TobiasRohner/STM/Hardware/ControlBoard/Control_Board_Voegel.png

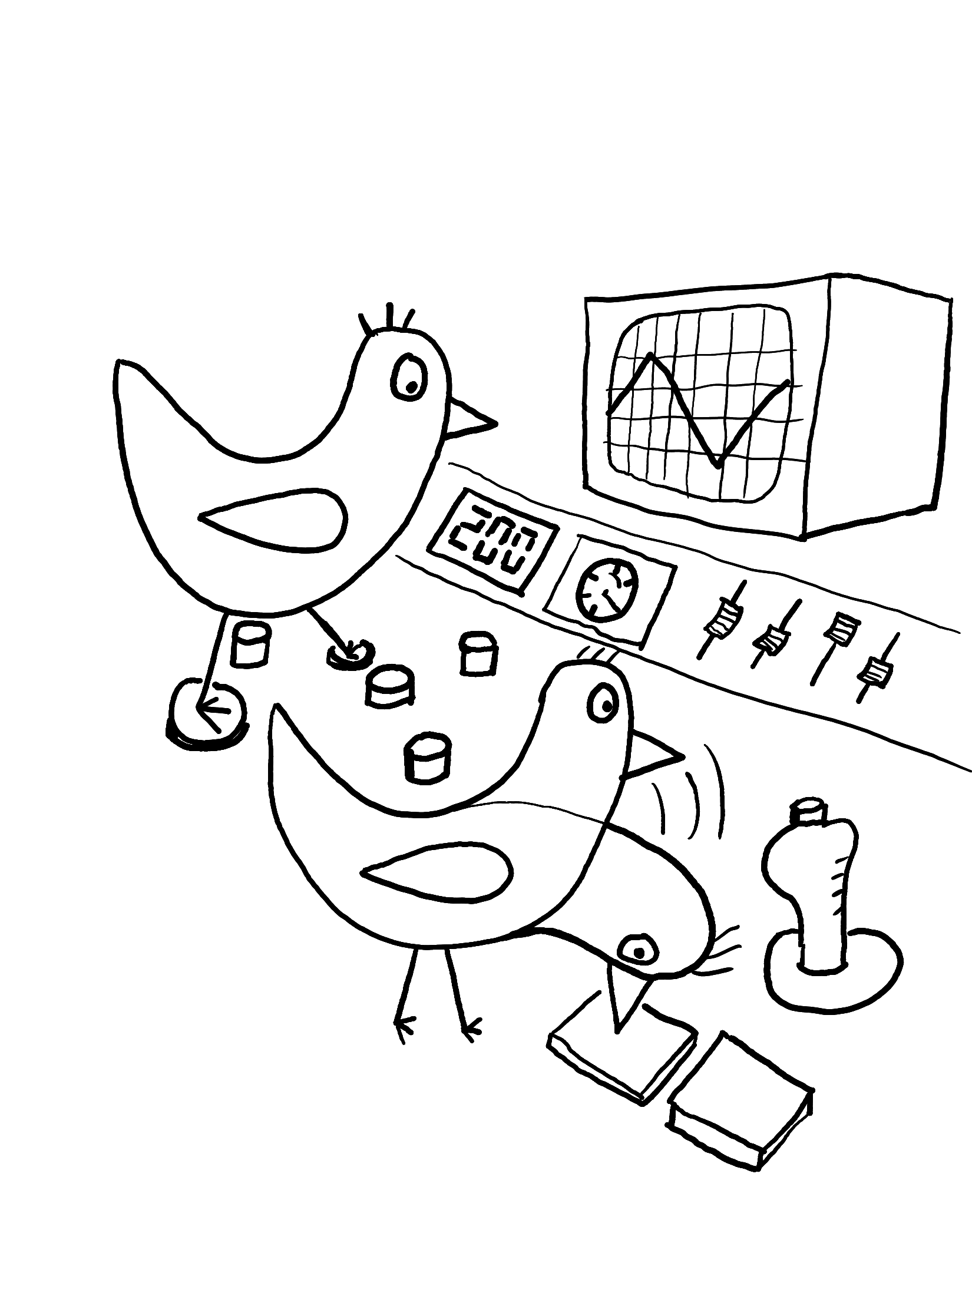
Hardware/ControlBoard/Control_Board_Voegel.png
