TobiasRohner/STM/Hardware/PSU/Artwork PSU.png

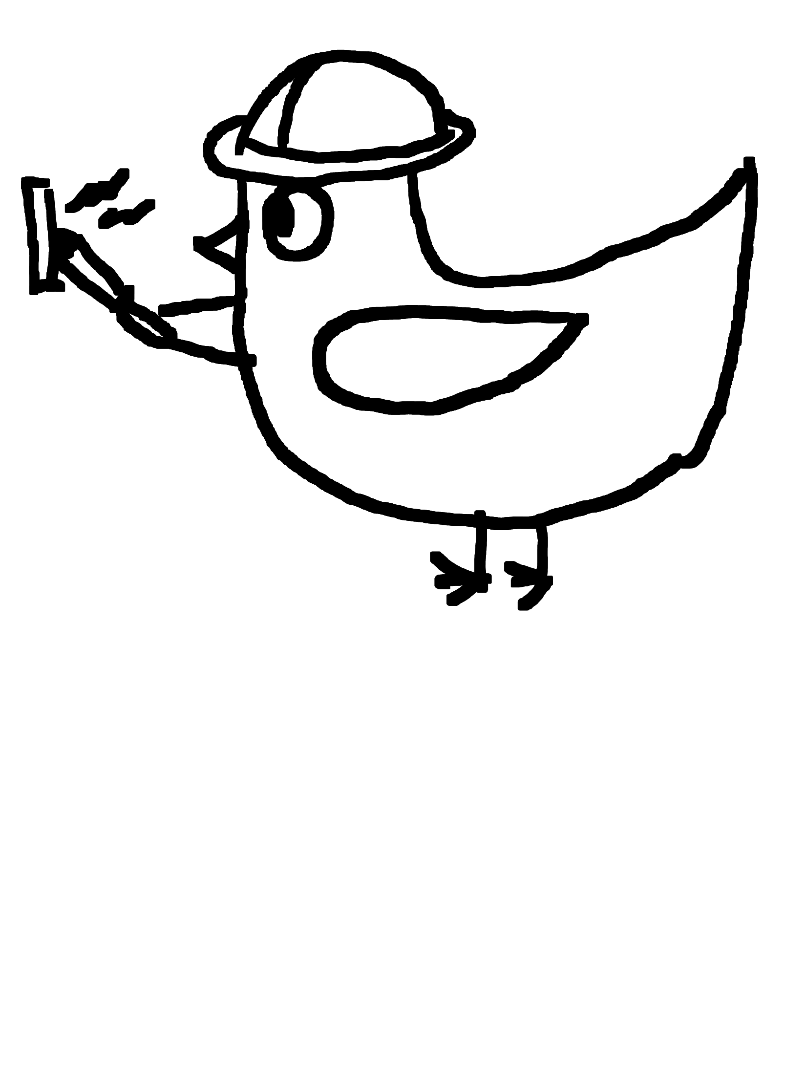
Hardware/PSU/Artwork PSU.png
