TobiasRohner/STM/Hardware/TIA/Artwork TIA.png

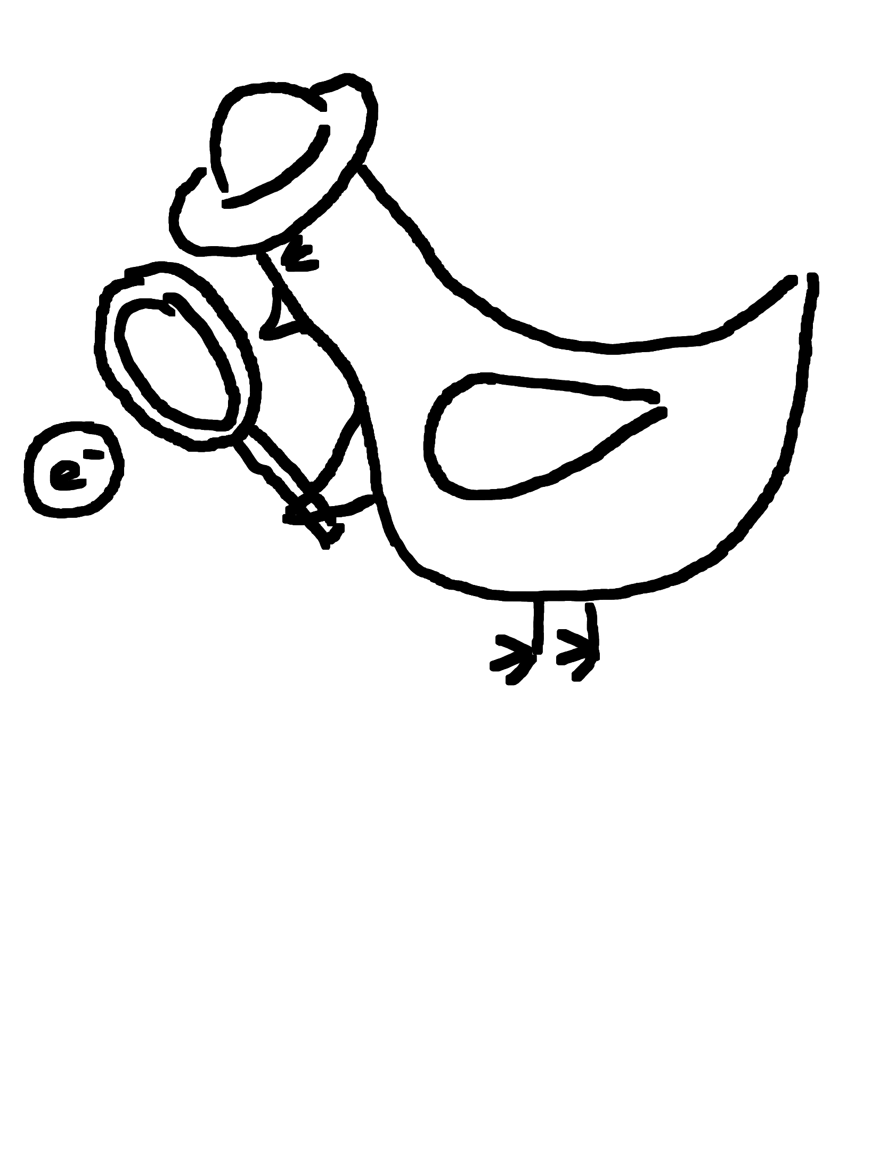
Hardware/TIA/Artwork TIA.png
