TobiasRohner/STM/Hardware/ControlBoard/OPA2227UA_2K5/THVD1429DT--3DModel-STEP-56544.STEP

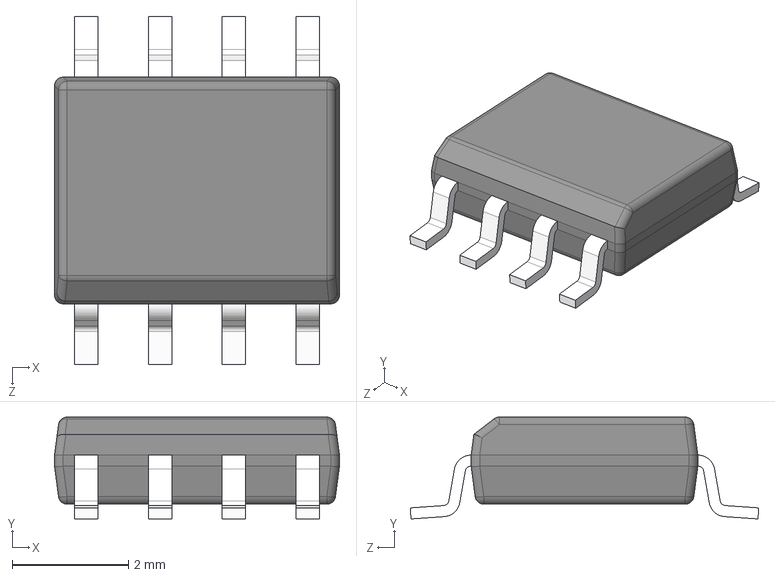
[picture p4: CAD file, 2022-01-10]
Hardware/ControlBoard/OPA2227UA_2K5/THVD1429DT--3DModel-STEP-56544.STEP
4.90 x 1.75 x 5.99 mm
