TobiasRohner/STM/Hardware/PSU/SS2PH10-M3/84A.STEP

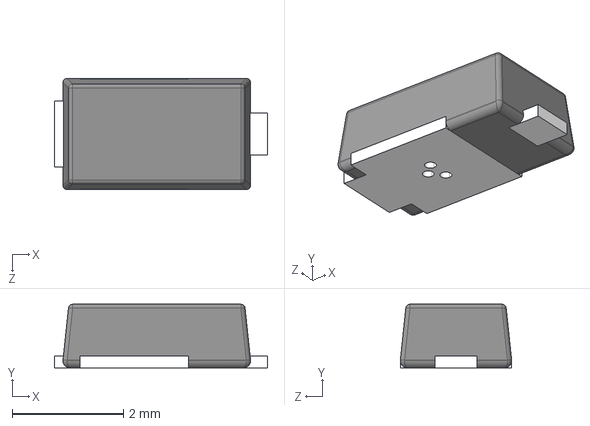
[picture p5: CAD file, 2022-01-10]
Hardware/PSU/SS2PH10-M3/84A.STEP
3.83 x 1.14 x 2.00 mm
