TobiasRohner/STM/Hardware/ControlBoard/10118194-0001LF/10118194-0001LF--3DModel-STEP-56544.STEP

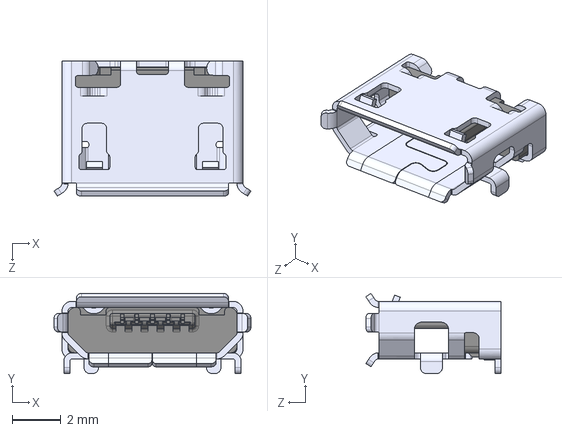
[picture p6: CAD file, 2022-01-10]
Hardware/ControlBoard/10118194-0001LF/10118194-0001LF--3DModel-STEP-56544.STEP
8.05 x 3.27 x 5.53 mm
