TobiasRohner/STM/Hardware/TIA/TIA.pdf

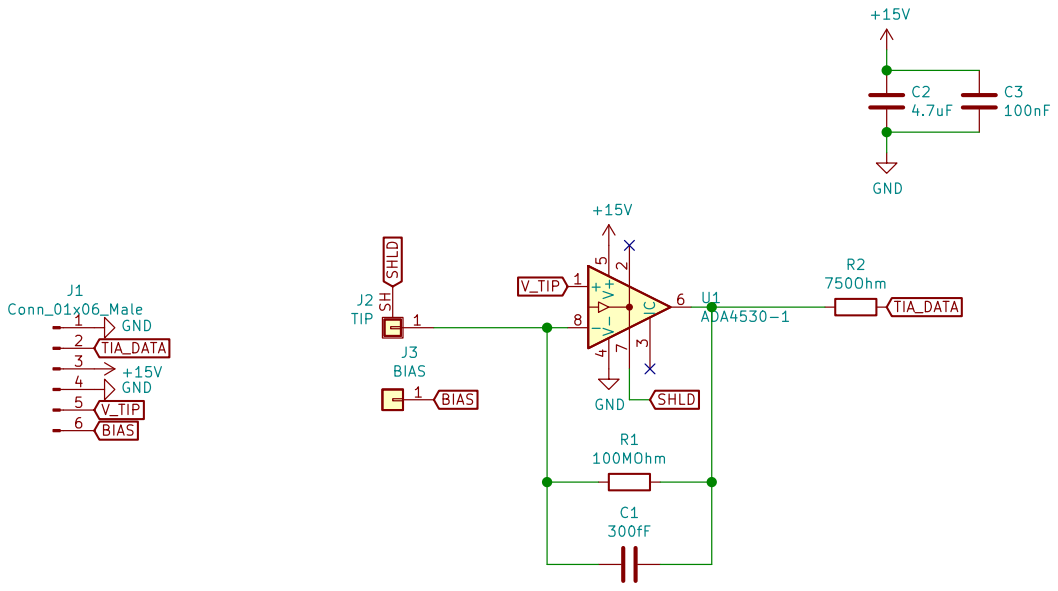
[picture p7: page 1]

Id: 1/1 Title: File: TIA.sch Sheet: /
