TobiasRohner/STM/Hardware/PSU/PSU.kicad_pcb

## KiCad design Hardware/PSU/PSU.kicad_pcb (2022-01-10)

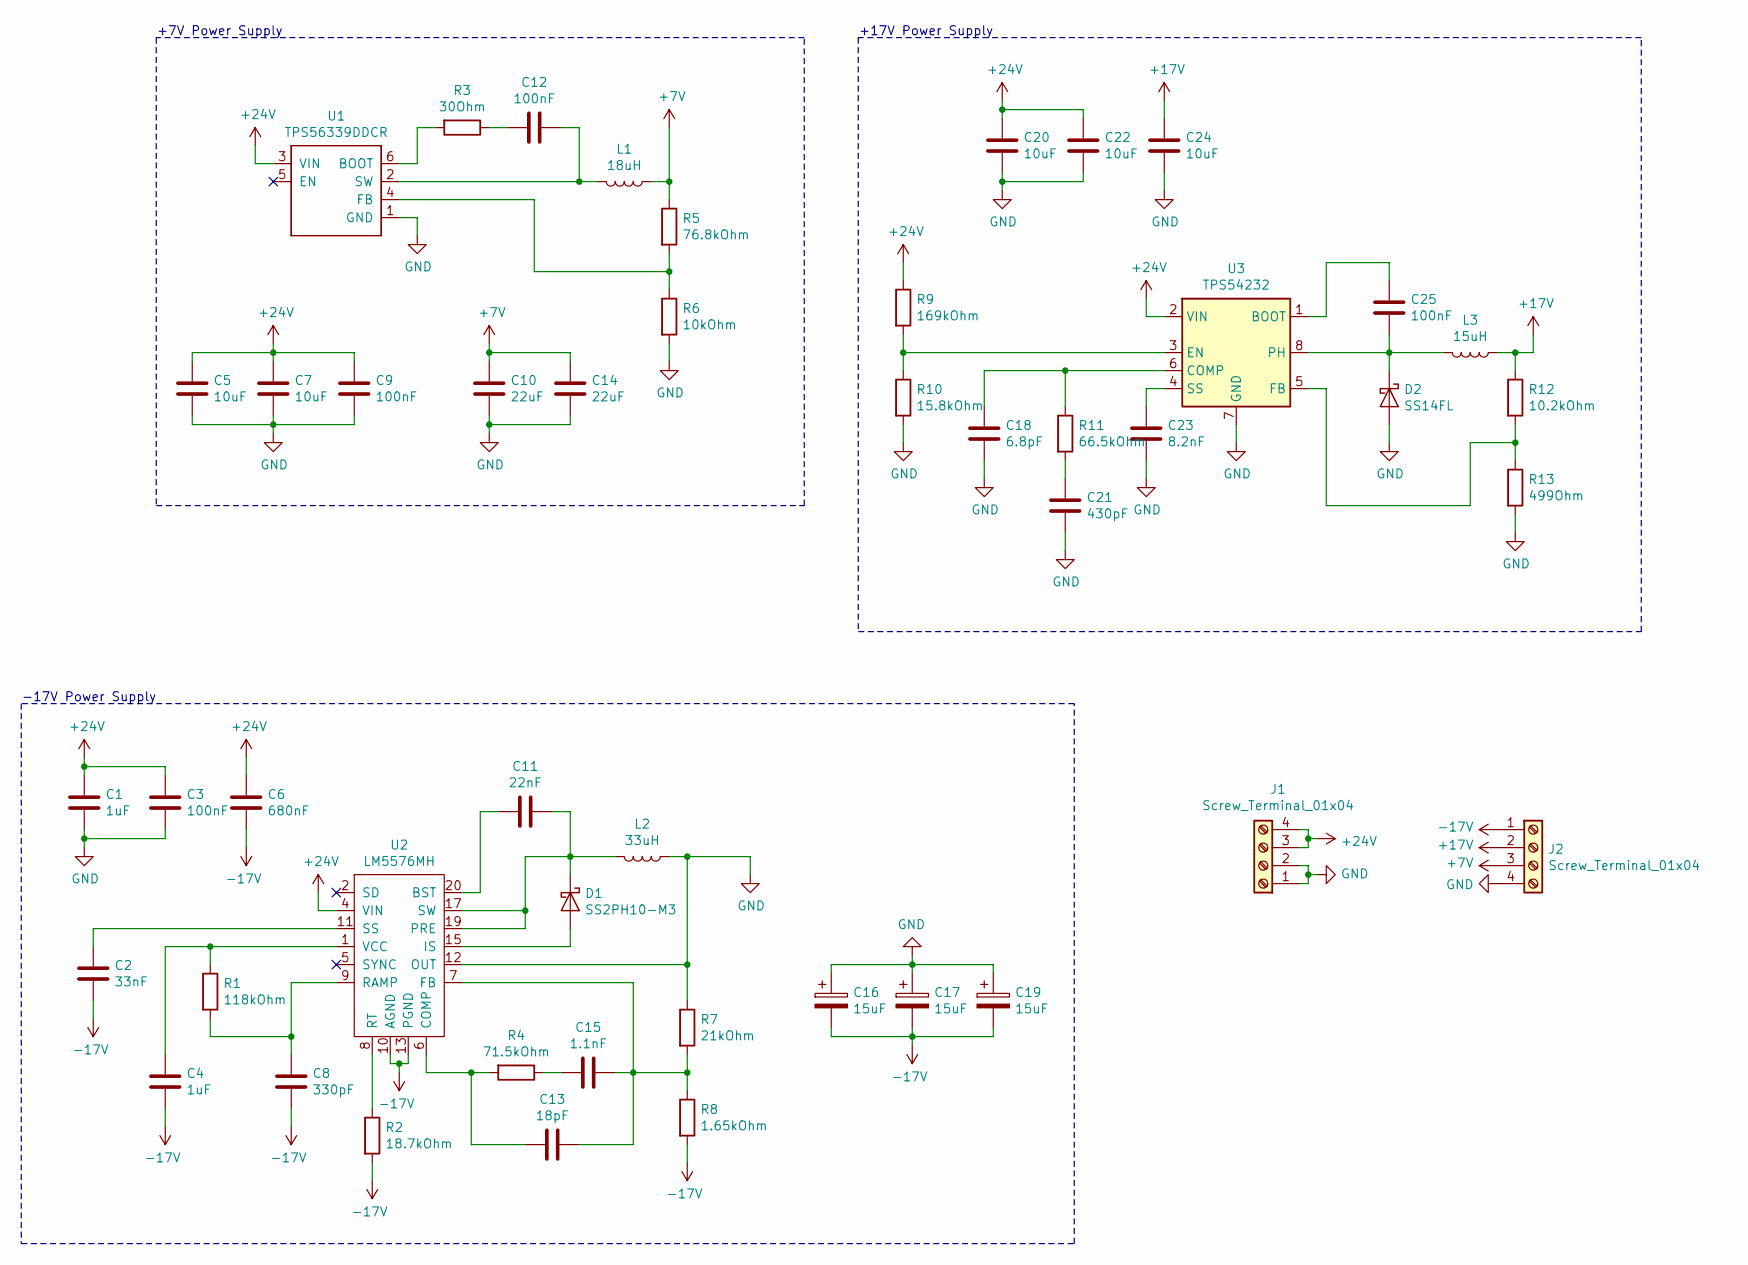
[picture p8: schematic PSU.sch]

Parts:
C1, C4: 1uF; C_0603_1608Metric_Pad1.05x0.95mm_HandSolder
C2: 33nF; C_0603_1608Metric_Pad1.05x0.95mm_HandSolder
C3, C9, C12: 100nF; C_0805_2012Metric_Pad1.15x1.40mm_HandSolder
C5, C7: 10uF; C_0805_2012Metric_Pad1.15x1.40mm_HandSolder
C6: 680nF; C_0805_2012Metric_Pad1.15x1.40mm_HandSolder
C8: 330pF; C_0603_1608Metric_Pad1.05x0.95mm_HandSolder
C10, C14: 22uF; C_1210_3225Metric_Pad1.42x2.65mm_HandSolder
C11: 22nF; C_0603_1608Metric_Pad1.05x0.95mm_HandSolder
C13: 18pF; C_0603_1608Metric_Pad1.05x0.95mm_HandSolder
C15: 1.1nF; C_0603_1608Metric_Pad1.05x0.95mm_HandSolder
C16, C17, C19: 15uF; CP_EIA-3528-21_Kemet-B_Pad1.50x2.35mm_HandSolder
C18: 6.8pF; C_0603_1608Metric_Pad1.05x0.95mm_HandSolder
C20, C22, C24: 10uF; C_1206_3216Metric_Pad1.42x1.75mm_HandSolder
C21: 430pF; C_0603_1608Metric_Pad1.05x0.95mm_HandSolder
C23: 8.2nF; C_0201_0603Metric
C25: 100nF; C_0603_1608Metric_Pad1.05x0.95mm_HandSolder
D1: SS2PH10-M3; DO-220AA
D2: SS14FL; SMAF
J1, J2: Screw_Terminal_01x04; BarrierBlock
L1: 18uH; MWSA1206S
L2: 33uH; MWSA1206S
L3: 15uH; MSA75-150M
R1: 118kOhm; R_0603_1608Metric_Pad1.05x0.95mm_HandSolder
R2: 18.7kOhm; R_0603_1608Metric_Pad1.05x0.95mm_HandSolder
R3: 30Ohm; R_0603_1608Metric_Pad1.05x0.95mm_HandSolder
R4: 71.5kOhm; R_0603_1608Metric_Pad1.05x0.95mm_HandSolder
R5: 76.8kOhm; R_0603_1608Metric_Pad1.05x0.95mm_HandSolder
R6: 10kOhm; R_0603_1608Metric_Pad1.05x0.95mm_HandSolder
R7: 21kOhm; R_0603_1608Metric_Pad1.05x0.95mm_HandSolder
R8: 1.65kOhm; R_0603_1608Metric_Pad1.05x0.95mm_HandSolder
R9: 169kOhm; R_0603_1608Metric_Pad1.05x0.95mm_HandSolder
R10: 15.8kOhm; R_0603_1608Metric_Pad1.05x0.95mm_HandSolder
R11: 66.5kOhm; R_0603_1608Metric_Pad1.05x0.95mm_HandSolder
R12: 10.2kOhm; R_0603_1608Metric_Pad1.05x0.95mm_HandSolder
R13: 499Ohm; R_0603_1608Metric_Pad1.05x0.95mm_HandSolder
U1: TPS56339DDCR; TSOT-23-6_HandSoldering
U2: LM5576MH; HTSSOP-20-1EP_4.4x6.5mm_P0.65mm_EP3.4x6.5mm_Mask2.75x3.43mm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
U3: TPS54232; SOIC-8_3.9x4.9mm_P1.27mm

Connections:
+7V: C10.1, C14.1, J2.3, L1.1, R5.1
+17V: C24.1, J2.2, L3.1, R12.1
+24V: C1.1, C3.1, C5.1, C6.1, C7.1, C9.1, C20.1, C22.1, J1.3, J1.4, R9.1, U1.3 (VIN), U2.3 (VIN), U2.4 (VIN), U3.2 (VIN)
-17V: C2.2, C4.2, C6.2, C8.2, C16.2, C17.2, C19.2, J2.1, R2.2, R8.2, U2.10 (AGND), U2.13 (PGND), U2.14 (PGND), U2.21 (AGND)
GND: C1.2, C3.2, C5.2, C7.2, C9.2, C10.2, C14.2, C16.1, C17.1, C18.2, C19.1, C20.2, C21.2, C22.2, C23.2, C24.2, D2.2 (A), J1.1, J1.2, J2.4, L2.1, R6.2, R7.1, R10.2, R13.2, U1.1 (GND), U2.12 (OUT), U3.7 (GND)
unnamed: C2.1, U2.11 (SS)
unnamed: C4.1, R1.1, U2.1 (VCC)
unnamed: C8.1, R1.2, U2.9 (RAMP)
unnamed: C11.1, D1.1 (K), L2.2, U2.17 (SW), U2.18 (SW), U2.19 (PRE)
unnamed: C11.2, U2.20 (BST)
unnamed: C12.1, L1.2, U1.2 (SW)
unnamed: C12.2, R3.1
unnamed: C13.1, C15.1, R7.2, R8.1, U2.7 (FB)
unnamed: C13.2, R4.2, U2.6 (COMP)
unnamed: C15.2, R4.1
unnamed: C18.1, R11.1, U3.6 (COMP)
unnamed: C21.1, R11.2
unnamed: C23.1, U3.4 (SS)
unnamed: C25.1, U3.1 (BOOT)
unnamed: C25.2, D2.1 (K), L3.2, U3.8 (PH)
unnamed: D1.2 (A), U2.15 (IS), U2.16 (IS)
unnamed: R2.1, U2.8 (RT)
unnamed: R3.2, U1.6 (BOOT)
unnamed: R5.2, R6.1, U1.4 (FB)
unnamed: R9.2, R10.1, U3.3 (EN)
unnamed: R12.2, R13.1, U3.5 (FB)

Notes on the sheet:
+7V Power Supply
+17V Power Supply
-17V Power Supply

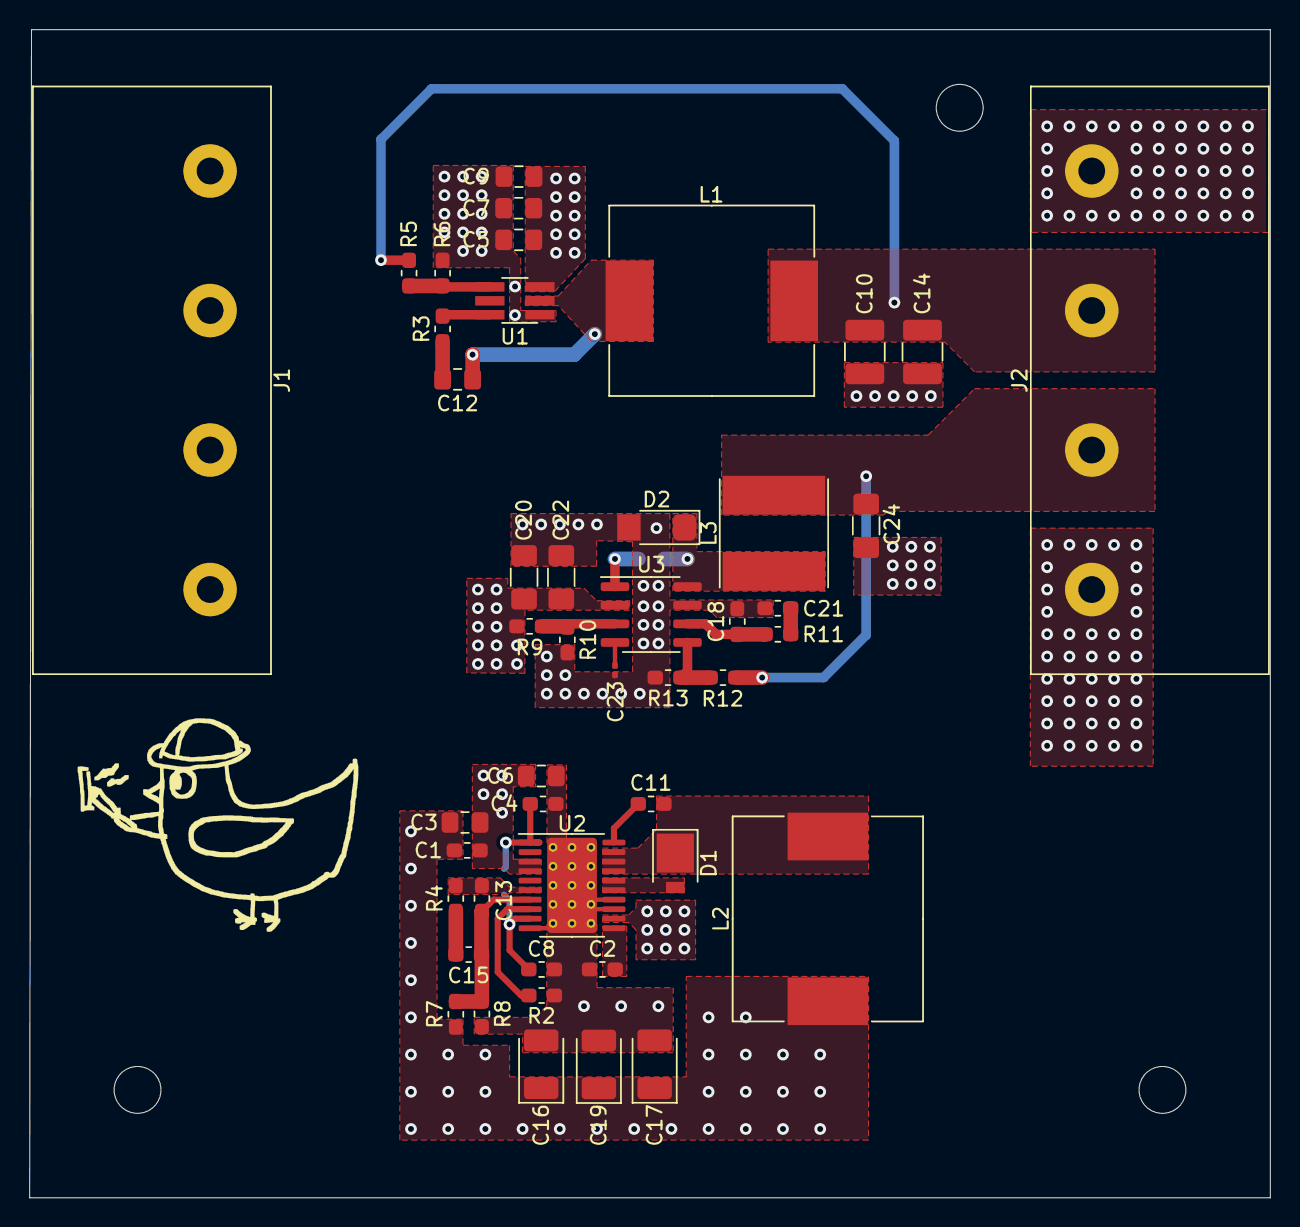
[picture p9: board PSU.kicad_pcb from above]

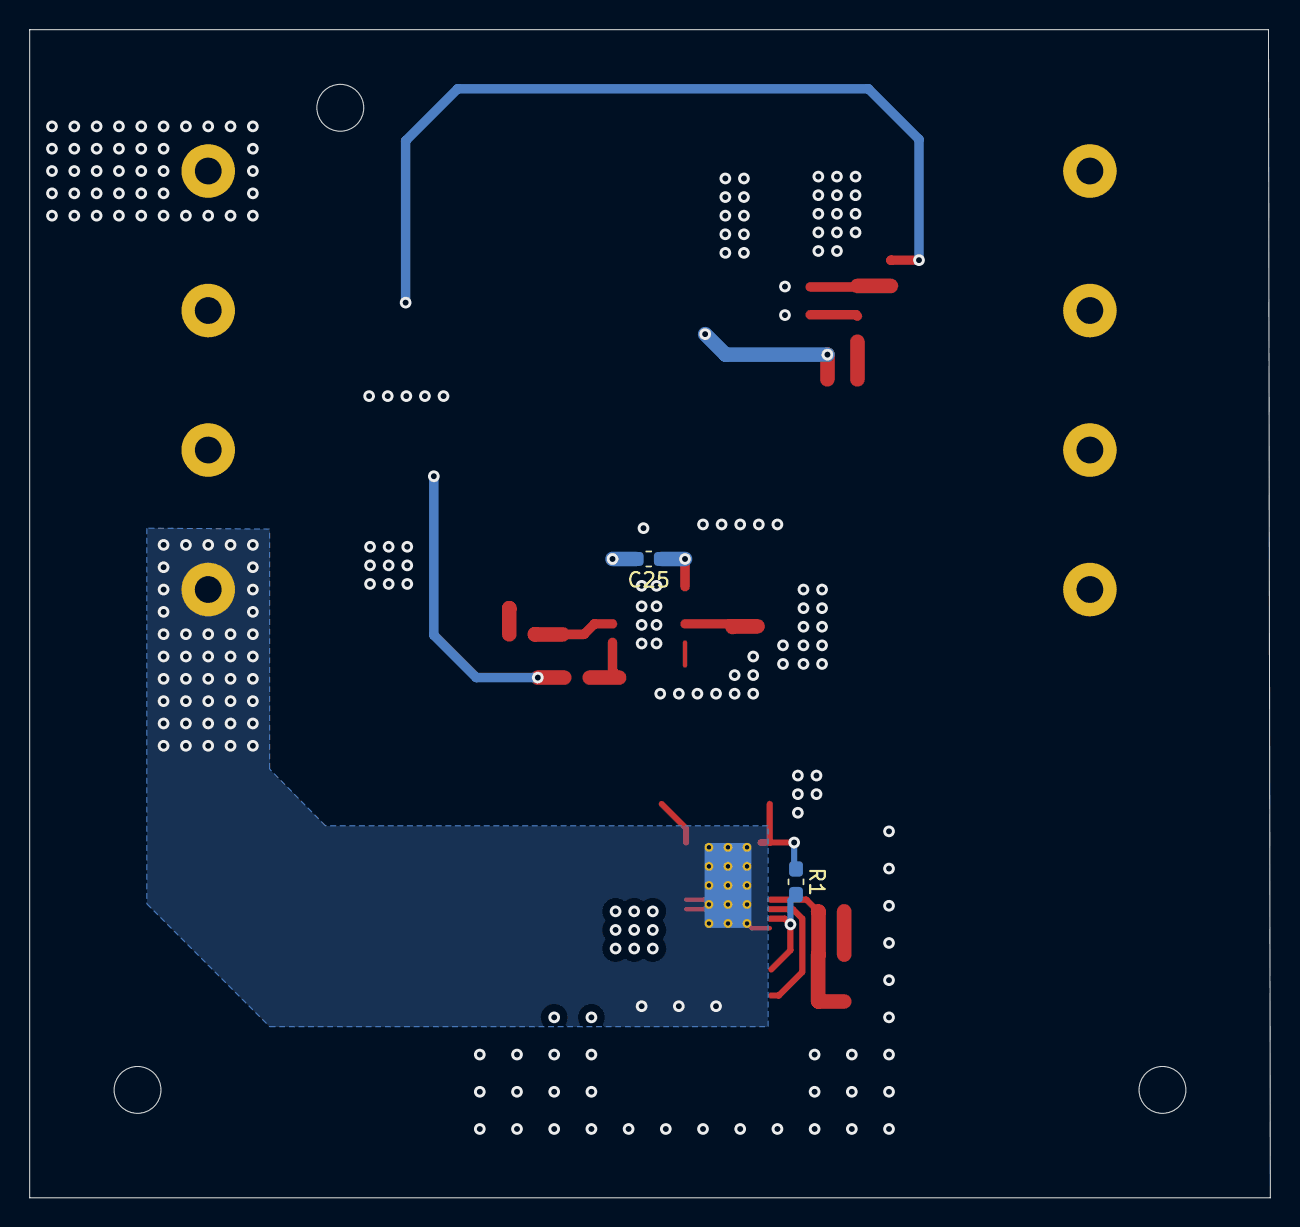
[picture p10: board PSU.kicad_pcb from below]

Board: 4 copper layers, 84.7 x 79.8 mm, 48 parts (2 on the bottom side), 26 nets.
