TobiasRohner/STM/Hardware/TIA/TIA.kicad_pcb

## KiCad design Hardware/TIA/TIA.kicad_pcb (2022-01-10)

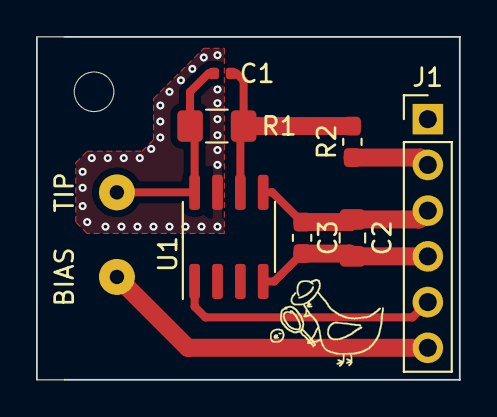
[picture p11: board TIA.kicad_pcb from above]

Board: 2 copper layers, 23.5 x 19.1 mm, 9 parts (0 on the bottom side), 7 nets.

Parts:
C1: 300fF; C_0402_1005Metric
C2: 4.7uF; C_0805_2012Metric_Pad1.15x1.40mm_HandSolder
C3: 100nF; C_0603_1608Metric_Pad1.05x0.95mm_HandSolder
J1: Conn_01x06_Male; PinHeader_1x06_P2.54mm_Vertical
J2: TIP; SolderWirePad_1x01_Drill0.8mm
J3: BIAS; SolderWirePad_1x01_Drill0.8mm
R1: 100MOhm; R_1206_3216Metric_Pad1.42x1.75mm_HandSolder
R2: 750Ohm; R_0603_1608Metric_Pad1.05x0.95mm_HandSolder
U1: ADA4530-1; SOIC-8_3.9x4.9mm_P1.27mm

Connections:
+15V: C2.1, C3.1, J1.3, U1.5
BIAS: J1.6, J3.1
GND: C2.2, C3.2, J1.1, J1.4, U1.4
unnamed: C1.1, R1.1, R2.2, U1.6
unnamed: C1.2, J2.1, R1.2, U1.8
TIA_DATA: J1.2, R2.1
V_TIP: J1.5, U1.1
