TobiasRohner/STM/Hardware/ControlBoard/ControlBoard.kicad_pcb

## KiCad design Hardware/ControlBoard/ControlBoard.kicad_pcb (2022-01-10)

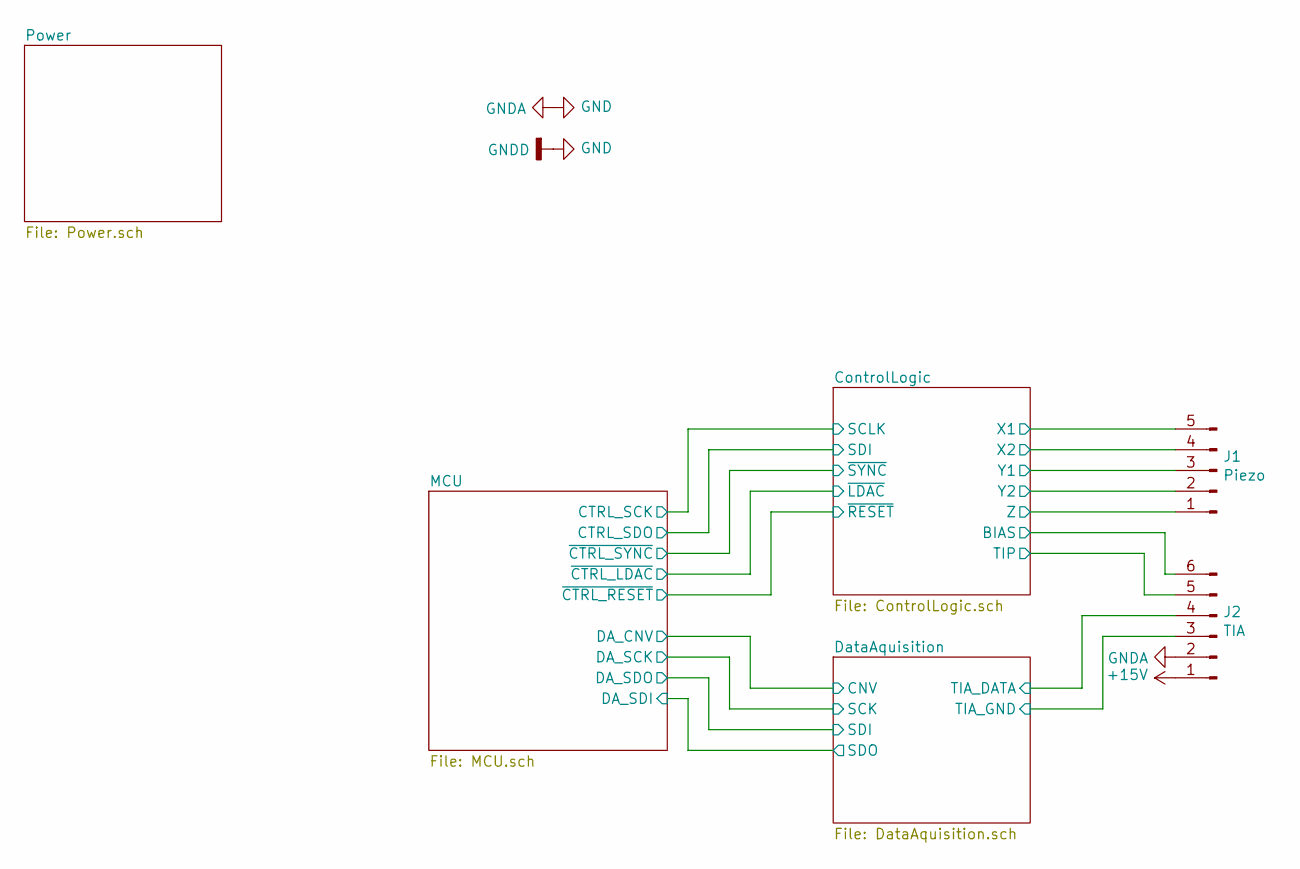
[picture p12: schematic ControlBoard.sch]

Parts:
J1: Piezo; PinHeader_1x05_P2.54mm_Vertical
J2: TIA; PinHeader_1x06_P2.54mm_Vertical

Connections:
+15V: J2.1; also elsewhere on the board
/ControlLogic/BIAS: J2.6; also elsewhere on the board
/ControlLogic/TIP: J2.5; also elsewhere on the board
/ControlLogic/X1: J1.5; also elsewhere on the board
/ControlLogic/X2: J1.4; also elsewhere on the board
/ControlLogic/Y1: J1.3; also elsewhere on the board
/ControlLogic/Y2: J1.2; also elsewhere on the board
/ControlLogic/Z: J1.1; also elsewhere on the board
/DataAquisition/TIA_DATA: J2.4; also elsewhere on the board
/DataAquisition/TIA_GND: J2.3; also elsewhere on the board
GND: J2.2; also elsewhere on the board

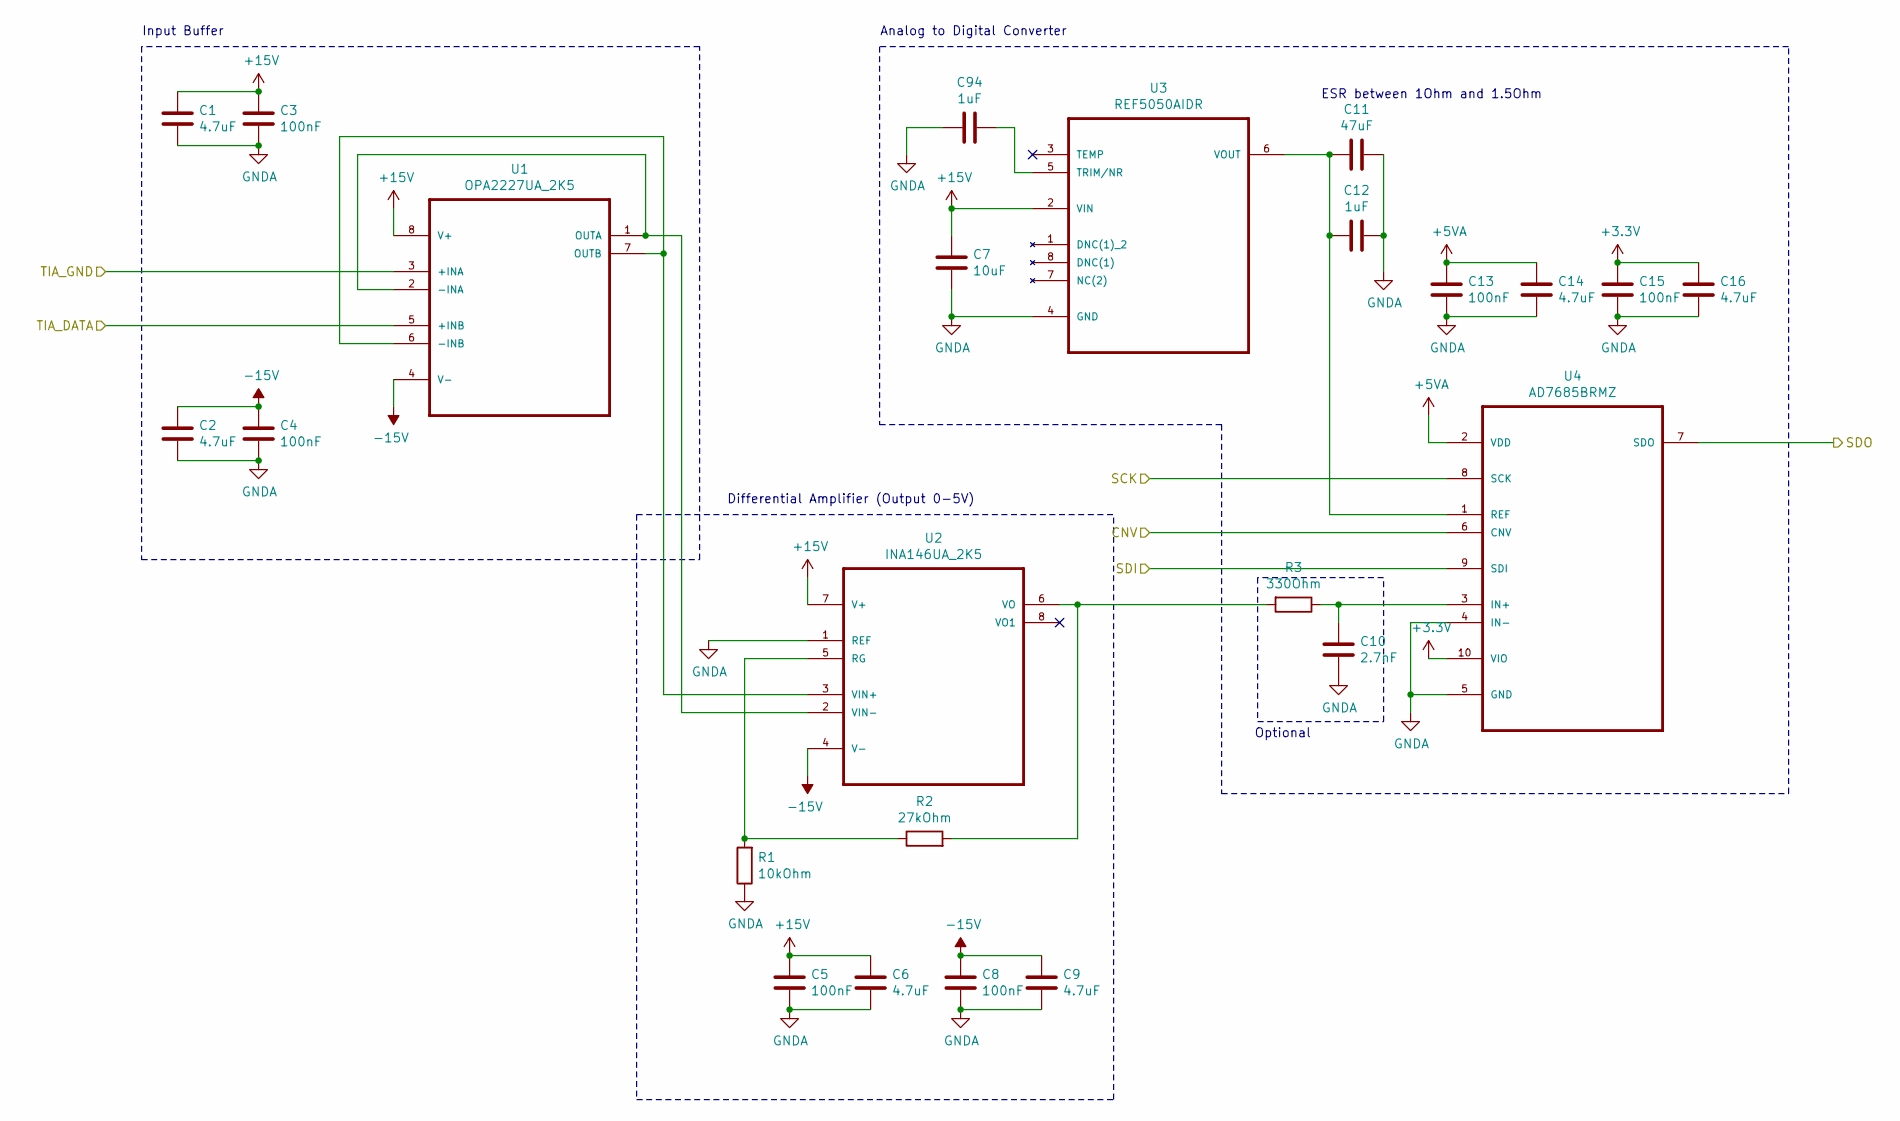
[picture p13: schematic DataAquisition.sch]

Parts:
C1, C2, C6, C9, C14, C16: 4.7uF; C_0805_2012Metric_Pad1.15x1.40mm_HandSolder
C3, C4, C5, C8, C13, C15: 100nF; C_0603_1608Metric_Pad1.05x0.95mm_HandSolder
C7: 10uF; C_1206_3216Metric_Pad1.42x1.75mm_HandSolder
C10: 2.7nF; C_0603_1608Metric_Pad1.05x0.95mm_HandSolder
C11: 47uF; C_1206_3216Metric_Pad1.42x1.75mm_HandSolder
C12, C94: 1uF; C_0603_1608Metric_Pad1.05x0.95mm_HandSolder
R1: 10kOhm; R_0603_1608Metric_Pad1.05x0.95mm_HandSolder
R2: 27kOhm; R_0603_1608Metric_Pad1.05x0.95mm_HandSolder
R3: 330Ohm; R_0603_1608Metric_Pad1.05x0.95mm_HandSolder
U1: OPA2227UA_2K5; SOIC-8-1EP_3.9x4.9mm_P1.27mm_EP2.29x3mm_ThermalVias
U2: INA146UA_2K5; SOIC-8-1EP_3.9x4.9mm_P1.27mm_EP2.29x3mm_ThermalVias
U3: REF5050AIDR; SOIC-8_3.9x4.9mm_P1.27mm
U4: AD7685BRMZ; MSOP-10_3x3mm_P0.5mm

Connections:
+3V3: C15.1, C16.1, U4.10 (VIO); also elsewhere on the board
+5VA: C13.1, C14.1, U4.2 (VDD); also elsewhere on the board
+15V: C1.1, C3.1, C5.1, C6.1, C7.1, U1.8 (V+), U2.7 (V+), U3.2 (VIN); also elsewhere on the board
-15V: C2.1, C4.1, C8.1, C9.1, U1.4 (V-), U2.4 (V-); also elsewhere on the board
/DataAquisition/TIA_DATA: U1.5 (+INB); also elsewhere on the board
/DataAquisition/TIA_GND: U1.3 (+INA); also elsewhere on the board
DA_CNV: U4.6 (CNV); also elsewhere on the board
GND: C1.2, C2.2, C3.2, C4.2, C5.2, C6.2, C7.2, C8.2, C9.2, C10.2, C11.1, C12.1, C13.2, C14.2, C15.2, C16.2, C94.2, R1.1, U2.1 (REF), U3.4 (GND), U4.4 (IN-), U4.5 (GND); also elsewhere on the board
unnamed: C10.1, R3.1, U4.3 (IN+)
unnamed: C11.2, C12.2, U3.6 (VOUT), U4.1 (REF)
unnamed: C94.1, U3.5 (TRIM/NR)
unnamed: R1.2, R2.1, U2.5 (RG)
unnamed: R2.2, R3.2, U2.6 (VO)
unnamed: U1.1 (OUTA), U1.2 (-INA), U2.2 (VIN-)
unnamed: U1.6 (-INB), U1.7 (OUTB), U2.3 (VIN+)
SPI1_MISO: U4.7 (SDO); also elsewhere on the board
SPI1_MOSI: U4.9 (SDI); also elsewhere on the board
SPI1_SCK: U4.8 (SCK); also elsewhere on the board

Notes on the sheet:
Input Buffer
Differential Amplifier (Output 0-5V)
Analog to Digital Converter
Optional
ESR between 1Ohm and 1.5Ohm

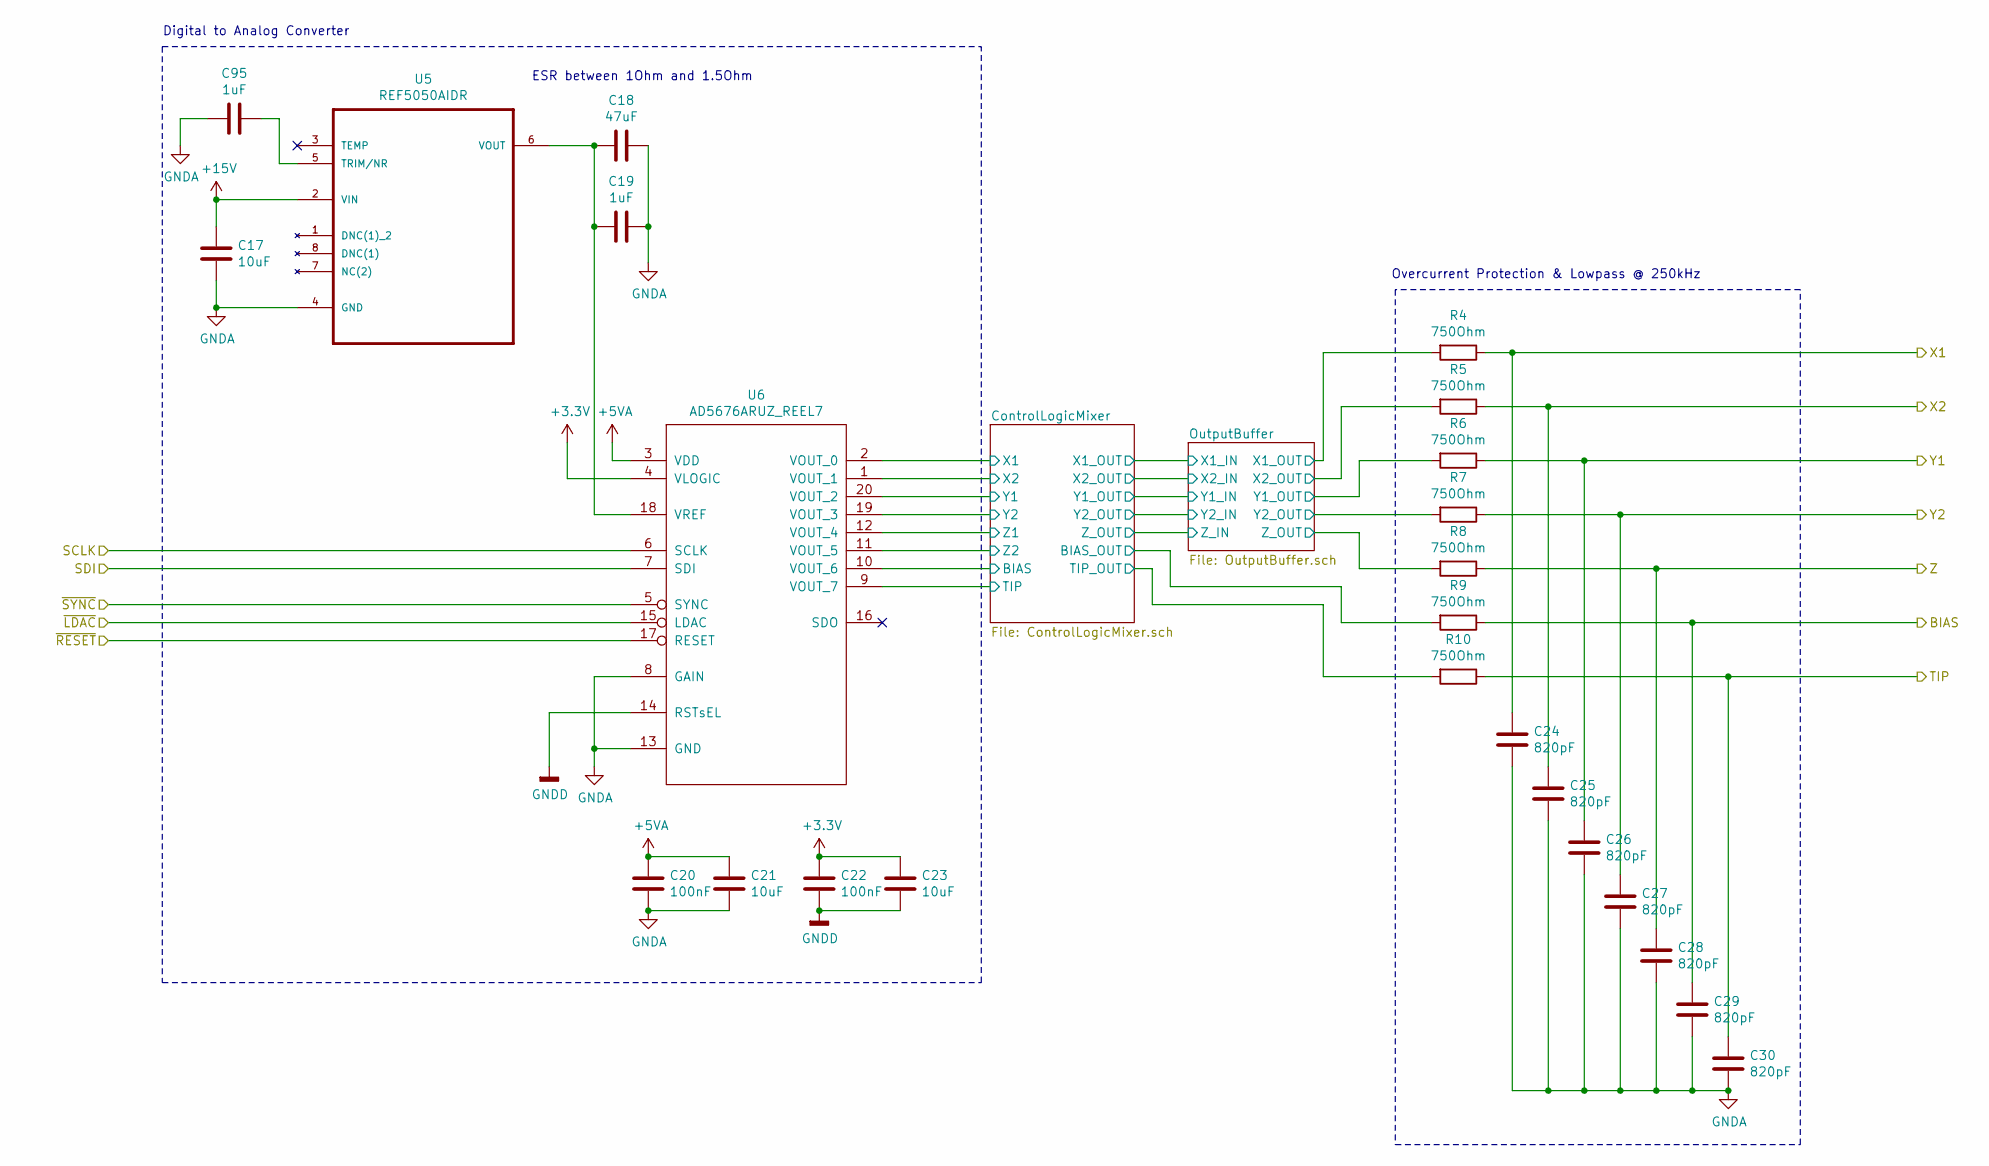
[picture p14: schematic ControlLogic.sch]

Parts:
C17, C21, C23: 10uF; C_1206_3216Metric_Pad1.42x1.75mm_HandSolder
C18: 47uF; C_1206_3216Metric_Pad1.42x1.75mm_HandSolder
C19, C95: 1uF; C_0603_1608Metric_Pad1.05x0.95mm_HandSolder
C20, C22: 100nF; C_0603_1608Metric_Pad1.05x0.95mm_HandSolder
C24, C25, C26, C27, C28, C29, C30: 820pF; C_0603_1608Metric_Pad1.05x0.95mm_HandSolder
R4, R5, R6, R7, R8, R9, R10: 750Ohm; R_0603_1608Metric_Pad1.05x0.95mm_HandSolder
U5: REF5050AIDR; SOIC-8_3.9x4.9mm_P1.27mm
U6: AD5676ARUZ_REEL7; TSSOP-20_4.4x6.5mm_P0.65mm

Connections:
+3V3: C22.1, C23.1, U6.4 (VLOGIC); also elsewhere on the board
+5VA: C20.1, C21.1, U6.3 (VDD); also elsewhere on the board
+15V: C17.1, U5.2 (VIN); also elsewhere on the board
/ControlLogic/BIAS: C29.1, R9.1; also elsewhere on the board
/ControlLogic/ControlLogicMixer/BIAS: U6.10 (VOUT_6); also elsewhere on the board
/ControlLogic/ControlLogicMixer/BIAS_OUT: R9.2; also elsewhere on the board
/ControlLogic/ControlLogicMixer/TIP: U6.9 (VOUT_7); also elsewhere on the board
/ControlLogic/ControlLogicMixer/TIP_OUT: R10.2; also elsewhere on the board
/ControlLogic/ControlLogicMixer/X1: U6.2 (VOUT_0); also elsewhere on the board
/ControlLogic/ControlLogicMixer/X2: U6.1 (VOUT_1); also elsewhere on the board
/ControlLogic/ControlLogicMixer/Y1: U6.20 (VOUT_2); also elsewhere on the board
/ControlLogic/ControlLogicMixer/Y2: U6.19 (VOUT_3); also elsewhere on the board
/ControlLogic/ControlLogicMixer/Z1: U6.12 (VOUT_4); also elsewhere on the board
/ControlLogic/ControlLogicMixer/Z2: U6.11 (VOUT_5); also elsewhere on the board
/ControlLogic/OutputBuffer/X1_OUT: R4.2; also elsewhere on the board
/ControlLogic/OutputBuffer/X2_OUT: R5.2; also elsewhere on the board
/ControlLogic/OutputBuffer/Y1_OUT: R6.2; also elsewhere on the board
/ControlLogic/OutputBuffer/Y2_OUT: R7.2; also elsewhere on the board
/ControlLogic/OutputBuffer/Z_OUT: R8.2; also elsewhere on the board
/ControlLogic/TIP: C30.1, R10.1; also elsewhere on the board
/ControlLogic/X1: C24.1, R4.1; also elsewhere on the board
/ControlLogic/X2: C25.1, R5.1; also elsewhere on the board
/ControlLogic/Y1: C26.1, R6.1; also elsewhere on the board
/ControlLogic/Y2: C27.1, R7.1; also elsewhere on the board
/ControlLogic/Z: C28.1, R8.1; also elsewhere on the board
GND: C17.2, C18.1, C19.1, C20.2, C21.2, C22.2, C23.2, C24.2, C25.2, C26.2, C27.2, C28.2, C29.2, C30.2, C95.2, U5.4 (GND), U6.8 (GAIN), U6.13 (GND), U6.14 (RSTsEL); also elsewhere on the board
unnamed: C18.2, C19.2, U5.6 (VOUT), U6.18 (VREF)
unnamed: C95.1, U5.5 (TRIM/NR)
SPI2_MOSI: U6.7 (SDI); also elsewhere on the board
SPI2_SCK: U6.6 (SCLK); also elsewhere on the board
~CTRL_LDAC: U6.15 (LDAC); also elsewhere on the board
~CTRL_RESET: U6.17 (RESET); also elsewhere on the board
~CTRL_SYNC: U6.5 (SYNC); also elsewhere on the board

Notes on the sheet:
Digital to Analog Converter
Overcurrent Protection & Lowpass @ 250kHz
ESR between 1Ohm and 1.5Ohm

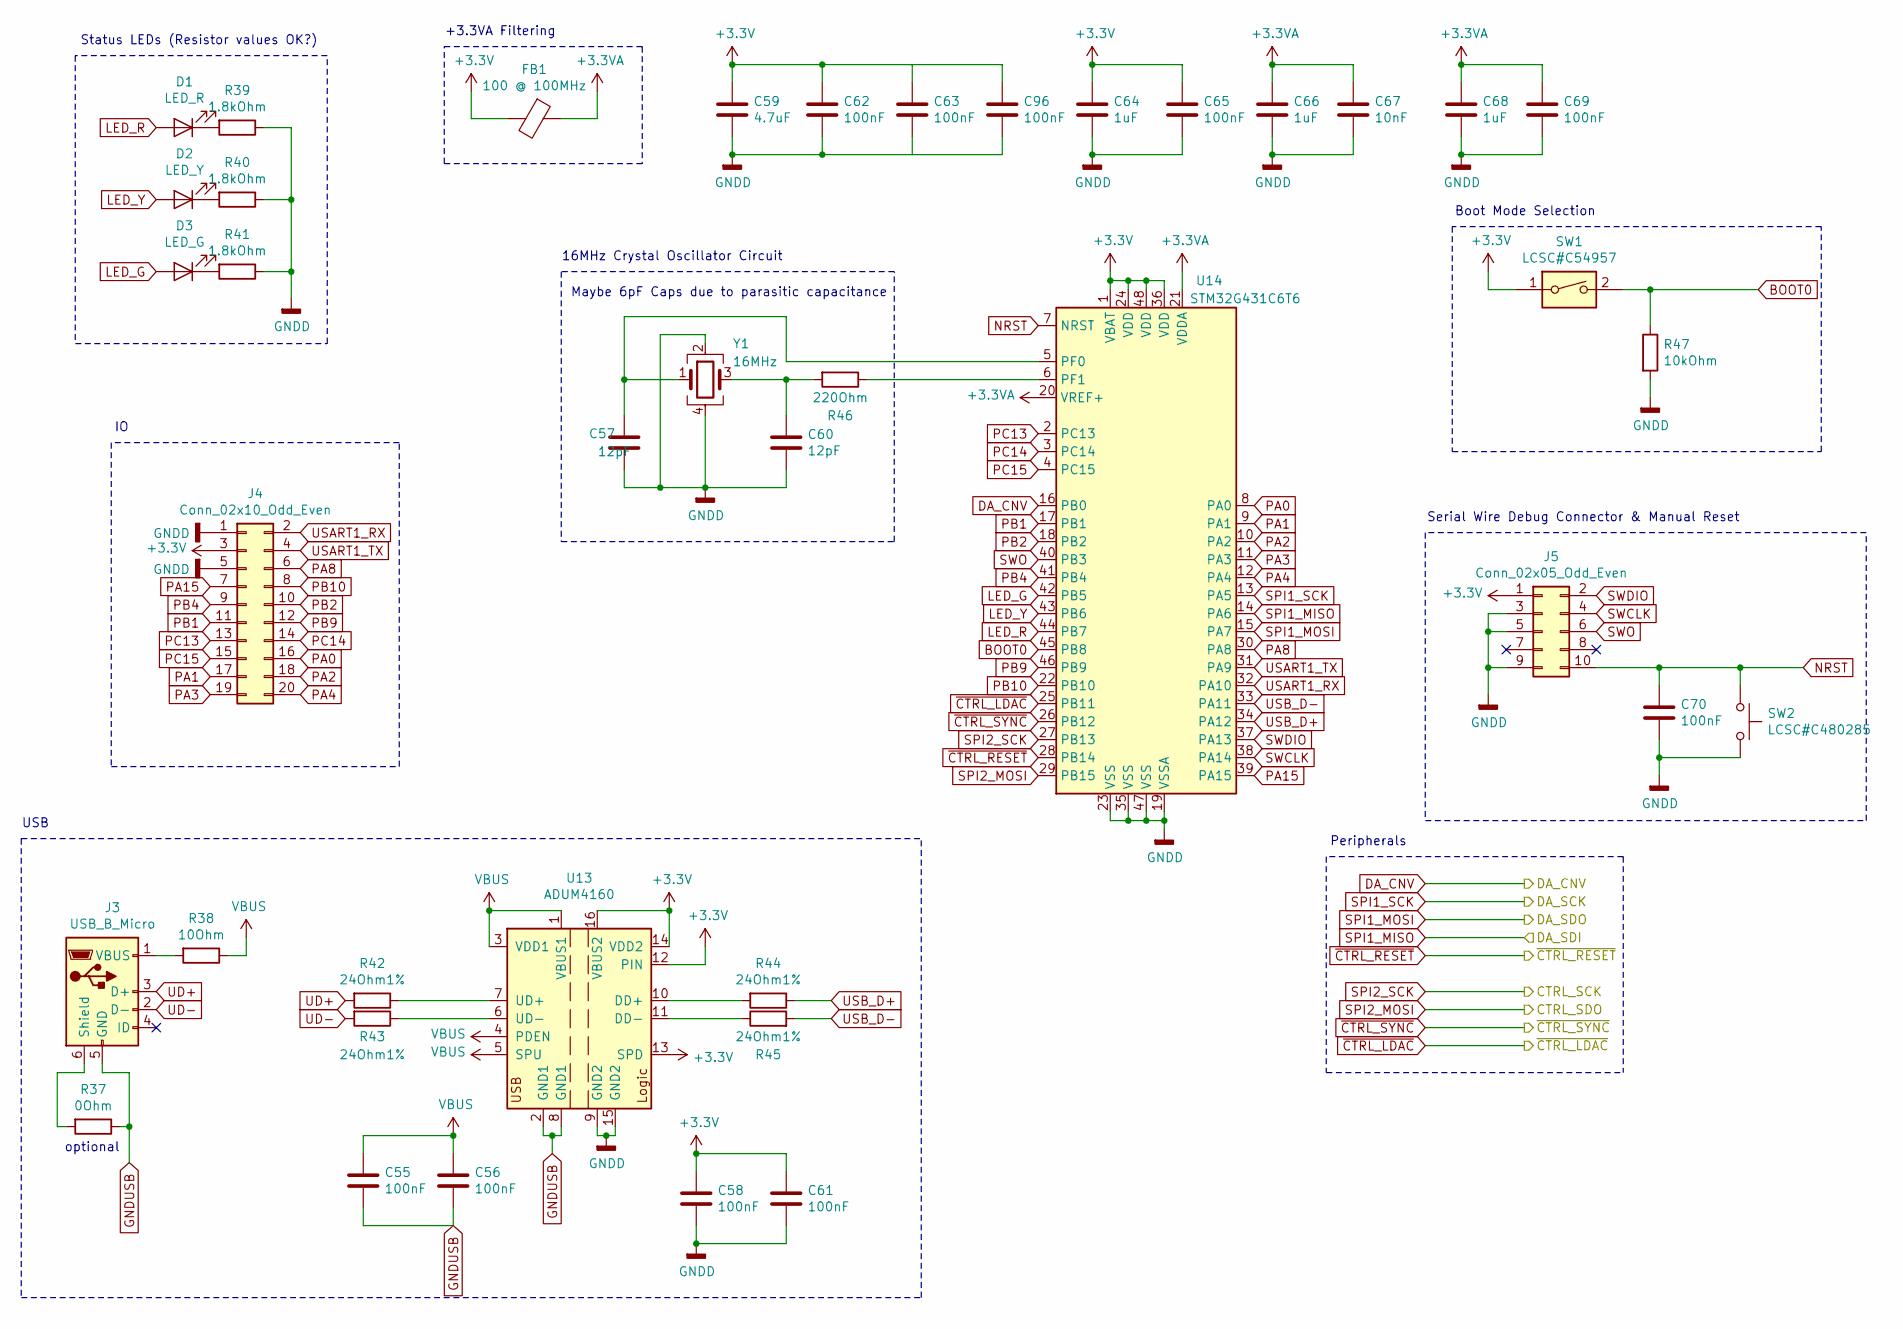
[picture p15: schematic MCU.sch]

Parts:
C55, C56, C58, C61, C62, C63, C65, C69, C70, C96: 100nF; C_0603_1608Metric_Pad1.05x0.95mm_HandSolder
C57, C60: 12pF; C_0603_1608Metric_Pad1.05x0.95mm_HandSolder
C59: 4.7uF; C_0805_2012Metric_Pad1.15x1.40mm_HandSolder
C64, C66, C68: 1uF; C_0603_1608Metric_Pad1.05x0.95mm_HandSolder
C67: 10nF; C_0603_1608Metric_Pad1.05x0.95mm_HandSolder
D1: LED_R; LED_0603_1608Metric_Pad1.05x0.95mm_HandSolder
D2: LED_Y; LED_0603_1608Metric_Pad1.05x0.95mm_HandSolder
D3: LED_G; LED_0603_1608Metric_Pad1.05x0.95mm_HandSolder
FB1: 100 @ 100MHz; L_0603_1608Metric_Pad1.05x0.95mm_HandSolder
J3: USB_B_Micro; USB_Micro-B_Molex-105017-0001
J4: Conn_02x10_Odd_Even; PinHeader_2x10_P2.54mm_Vertical
J5: Conn_02x05_Odd_Even; PinHeader_2x05_P1.27mm_Vertical_SMD
R37: 0Ohm; R_0603_1608Metric_Pad1.05x0.95mm_HandSolder
R38: 10Ohm; R_0603_1608Metric_Pad1.05x0.95mm_HandSolder
R39, R40, R41: 1.8kOhm; R_0603_1608Metric_Pad1.05x0.95mm_HandSolder
R42, R43, R44, R45: 24Ohm1%; R_0603_1608Metric_Pad1.05x0.95mm_HandSolder
R46: 220Ohm; R_0603_1608Metric_Pad1.05x0.95mm_HandSolder
R47: 10kOhm; R_0603_1608Metric_Pad1.05x0.95mm_HandSolder
SW1: LCSC#C54957; SW_DIP_SPSTx01_Slide_6.7x4.1mm_W7.62mm_P2.54mm_LowProfile
SW2: LCSC#C480285; SW_PUSH_6mm
U13: ADUM4160; SOIC-16W_7.5x10.3mm_P1.27mm
U14: STM32G431C6T6; LQFP-48_7x7mm_P0.5mm
Y1: 16MHz; Crystal_SMD_3225-4Pin_3.2x2.5mm_HandSoldering

Connections:
+3.3VA: C66.1, C67.1, C68.1, C69.1, FB1.1, U14.20 (VREF+), U14.21 (VDDA)
+3V3: C58.1, C59.1, C61.1, C62.1, C63.1, C64.1, C65.1, C96.1, FB1.2, J4.3, J5.1, SW1.1, U13.12 (PIN), U13.13 (SPD), U13.14 (VDD2), U13.16 (VBUS2), U14.1 (VBAT), U14.24 (VDD), U14.36 (VDD), U14.48 (VDD); also elsewhere on the board
BOOT0: R47.1, SW1.2, U14.45 (PB8)
DA_CNV: U14.16 (PB0); also elsewhere on the board
GND: C57.2, C58.2, C59.2, C60.2, C61.2, C62.2, C63.2, C64.2, C65.2, C66.2, C67.2, C68.2, C69.2, C70.2, C96.2, J4.1, J4.5, J5.3, J5.5, J5.9, R39.1, R40.1, R41.1, R47.2, SW2.2, U13.9 (GND2), U13.15 (GND2), U14.19 (VSSA), U14.23 (VSS), U14.35 (VSS), U14.47 (VSS), Y1.2, Y1.4; also elsewhere on the board
GNDUSB: C55.2, C56.2, J3.5 (GND), R37.1, U13.2 (GND1), U13.8 (GND1)
LED_G: D3.2 (A), U14.42 (PB5)
LED_R: D1.2 (A), U14.44 (PB7)
LED_Y: D2.2 (A), U14.43 (PB6)
NRST: C70.1, J5.10, SW2.1, U14.7 (NRST)
unnamed: C57.1, U14.5 (PF0), Y1.1
unnamed: C60.1, R46.2, Y1.3
unnamed: D1.1 (K), R39.2
unnamed: D2.1 (K), R40.2
unnamed: D3.1 (K), R41.2
unnamed: J3.1 (VBUS), R38.2
unnamed: J3.6 (Shield), R37.2
unnamed: R42.1, U13.7 (UD+)
unnamed: R43.1, U13.6 (UD-)
unnamed: R44.2, U13.10 (DD+)
unnamed: R45.1, U13.11 (DD-)
unnamed: R46.1, U14.6 (PF1)
PA0: J4.16, U14.8 (PA0)
PA1: J4.17, U14.9 (PA1)
PA2: J4.18, U14.10 (PA2)
PA3: J4.19, U14.11 (PA3)
PA4: J4.20, U14.12 (PA4)
PA8: J4.6, U14.30 (PA8)
PA15: J4.7, U14.39 (PA15)
PB1: J4.11, U14.17 (PB1)
PB2: J4.10, U14.18 (PB2)
PB4: J4.9, U14.41 (PB4)
PB9: J4.12, U14.46 (PB9)
PB10: J4.8, U14.22 (PB10)
PC13: J4.13, U14.2 (PC13)
PC14: J4.14, U14.3 (PC14)
PC15: J4.15, U14.4 (PC15)
SPI1_MISO: U14.14 (PA6); also elsewhere on the board
SPI1_MOSI: U14.15 (PA7); also elsewhere on the board
SPI1_SCK: U14.13 (PA5); also elsewhere on the board
SPI2_MOSI: U14.29 (PB15); also elsewhere on the board
SPI2_SCK: U14.27 (PB13); also elsewhere on the board
SWCLK: J5.4, U14.38 (PA14)
SWDIO: J5.2, U14.37 (PA13)
SWO: J5.6, U14.40 (PB3)
UD+: J3.3 (D+), R42.2
UD-: J3.2 (D-), R43.2
USART1_RX: J4.2, U14.32 (PA10)
USART1_TX: J4.4, U14.31 (PA9)
USB_D+: R44.1, U14.34 (PA12)
USB_D-: R45.2, U14.33 (PA11)
VBUS: C55.1, C56.1, R38.1, U13.1 (VBUS1), U13.3 (VDD1), U13.4 (PDEN), U13.5 (SPU)
~CTRL_LDAC: U14.25 (PB11); also elsewhere on the board
~CTRL_RESET: U14.28 (PB14); also elsewhere on the board
~CTRL_SYNC: U14.26 (PB12); also elsewhere on the board

Notes on the sheet:
16MHz Crystal Oscillator Circuit
+3.3VA Filtering
Boot Mode Selection
Serial Wire Debug Connector & Manual Reset
optional
USB
Peripherals
Status LEDs (Resistor values OK?)
Maybe 6pF Caps due to parasitic capacitance
