TobiasRohner/STM/Hardware/ControlBoard/ControlBoard.kicad_pcb

## KiCad design Hardware/ControlBoard/ControlBoard.kicad_pcb (continued)

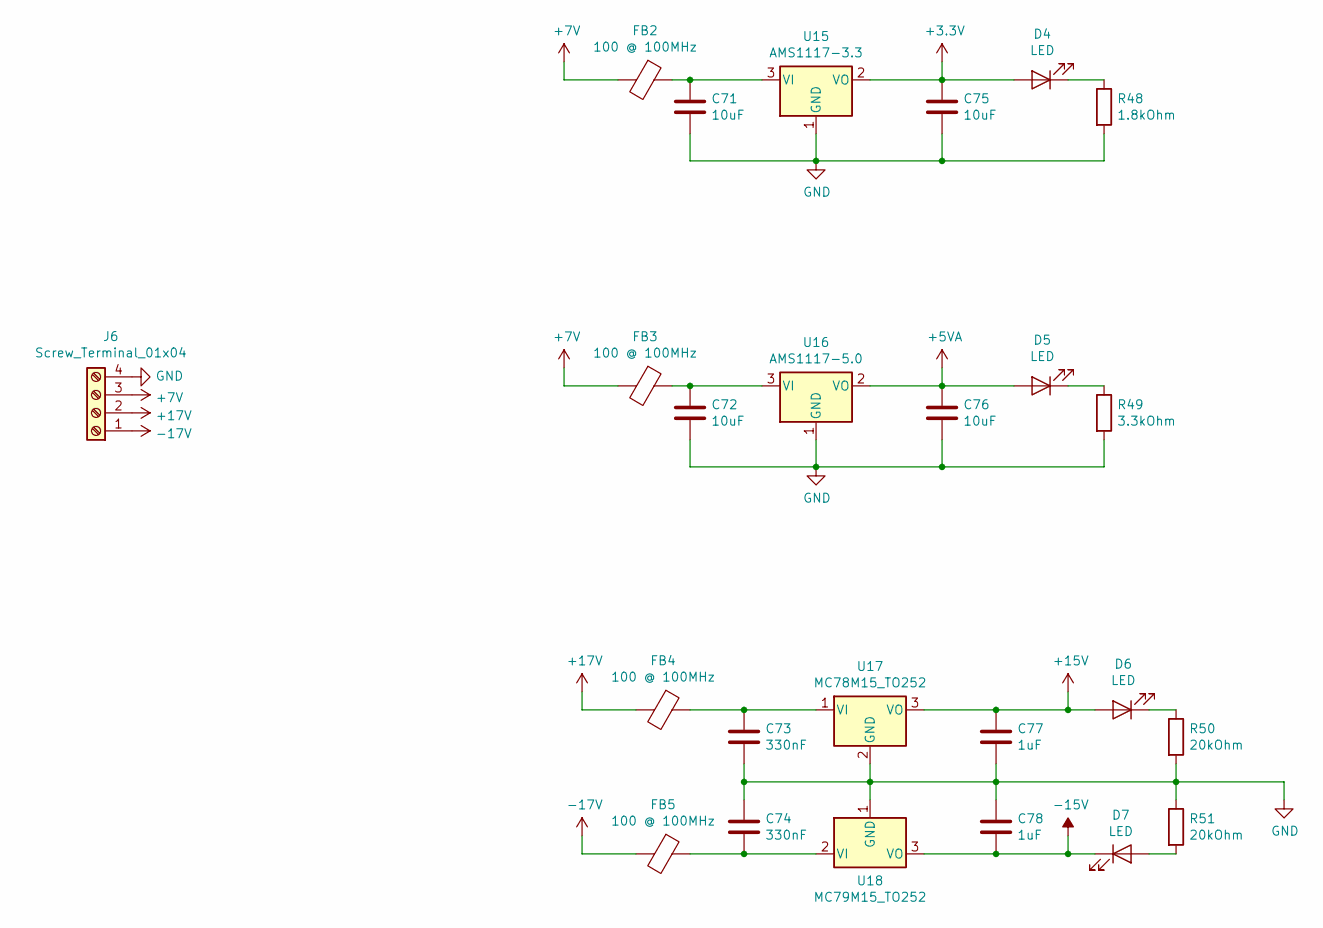
[picture p16: schematic Power.sch]

Parts:
C71, C72, C75, C76: 10uF; C_1206_3216Metric_Pad1.42x1.75mm_HandSolder
C73, C74: 330nF; C_0603_1608Metric_Pad1.05x0.95mm_HandSolder
C77, C78: 1uF; C_0603_1608Metric_Pad1.05x0.95mm_HandSolder
D4, D5, D6, D7: LED; LED_0603_1608Metric_Pad1.05x0.95mm_HandSolder
FB2, FB3, FB4, FB5: 100 @ 100MHz; L_0603_1608Metric_Pad1.05x0.95mm_HandSolder
J6: Screw_Terminal_01x04; BarrierBlock
R48: 1.8kOhm; R_0603_1608Metric_Pad1.05x0.95mm_HandSolder
R49: 3.3kOhm; R_0603_1608Metric_Pad1.05x0.95mm_HandSolder
R50, R51: 20kOhm; R_1206_3216Metric_Pad1.42x1.75mm_HandSolder
U15: AMS1117-3.3; SOT-223-3_TabPin2
U16: AMS1117-5.0; SOT-223-3_TabPin2
U17: MC78M15_TO252; TO-252-2
U18: MC79M15_TO252; TO-252-2

Connections:
+3V3: C75.1, D4.2 (A), U15.2 (VO); also elsewhere on the board
+5VA: C76.1, D5.2 (A), U16.2 (VO); also elsewhere on the board
+7V: FB2.2, FB3.2, J6.3
+15V: C77.1, D6.2 (A), U17.3 (VO); also elsewhere on the board
+17V: FB4.2, J6.2
-15V: C78.2, D7.1 (K), U18.3 (VO); also elsewhere on the board
-17V: FB5.2, J6.1
GND: C71.2, C72.2, C73.2, C74.1, C75.2, C76.2, C77.2, C78.1, J6.4, R48.2, R49.2, R50.2, R51.1, U15.1 (GND), U16.1 (GND), U17.2 (GND), U18.1 (GND); also elsewhere on the board
unnamed: C71.1, FB2.1, U15.3 (VI)
unnamed: C72.1, FB3.1, U16.3 (VI)
unnamed: C73.1, FB4.1, U17.1 (VI)
unnamed: C74.2, FB5.1, U18.2 (VI)
unnamed: D4.1 (K), R48.1
unnamed: D5.1 (K), R49.1
unnamed: D6.1 (K), R50.1
unnamed: D7.2 (A), R51.2

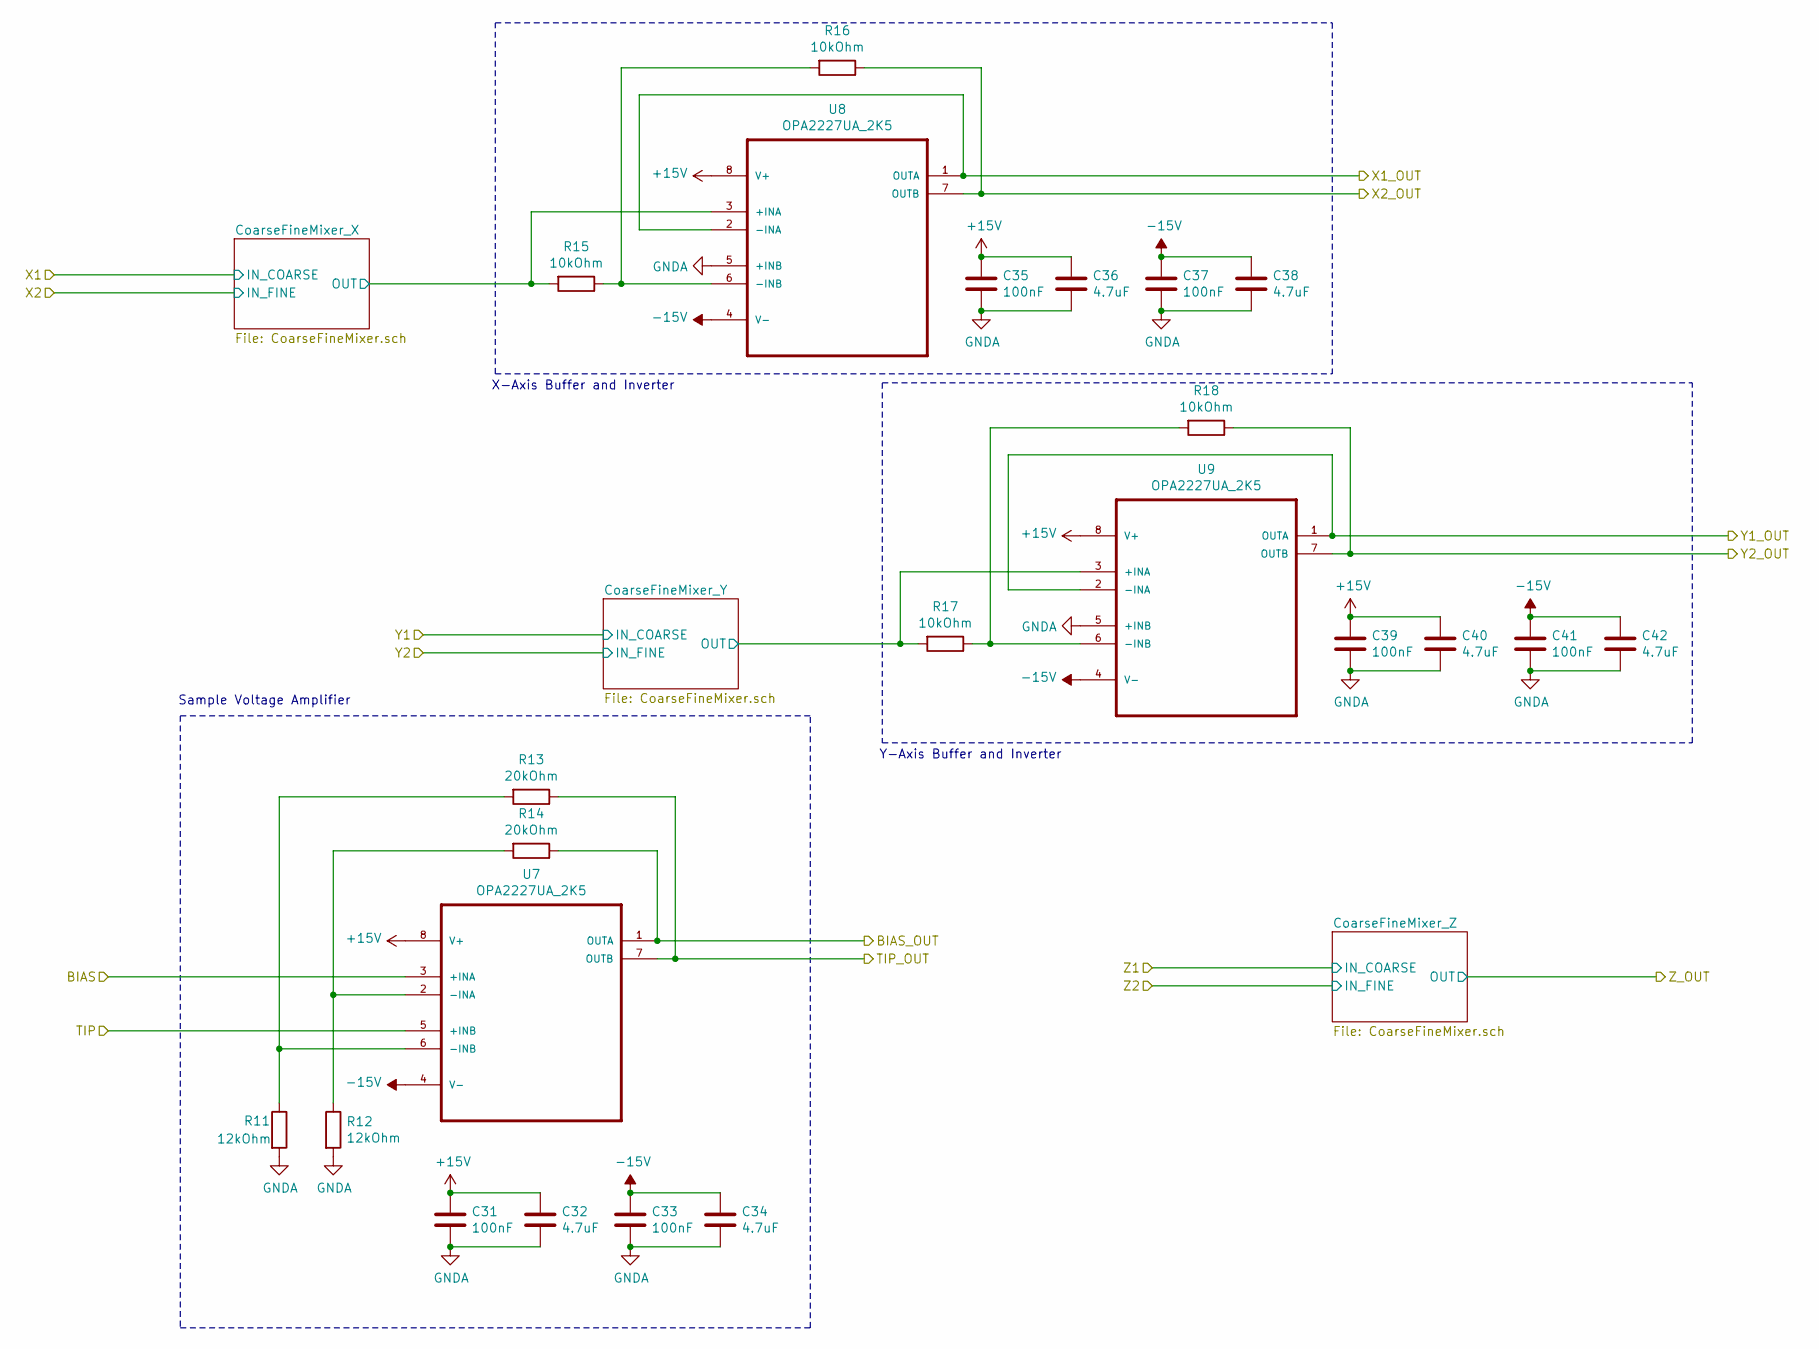
[picture p17: schematic ControlLogicMixer.sch]

Parts:
C31, C33, C35, C37, C39, C41: 100nF; C_0603_1608Metric_Pad1.05x0.95mm_HandSolder
C32, C34, C36, C38, C40, C42: 4.7uF; C_0805_2012Metric_Pad1.15x1.40mm_HandSolder
R11, R12: 12kOhm; R_0603_1608Metric_Pad1.05x0.95mm_HandSolder
R13, R14: 20kOhm; R_0603_1608Metric_Pad1.05x0.95mm_HandSolder
R15, R16, R17, R18: 10kOhm; R_0603_1608Metric_Pad1.05x0.95mm_HandSolder
U7, U8, U9: OPA2227UA_2K5; SOIC-8-1EP_3.9x4.9mm_P1.27mm_EP2.29x3mm_ThermalVias

Connections:
+15V: C31.1, C32.1, C35.1, C36.1, C39.1, C40.1, U7.8 (V+), U8.8 (V+), U9.8 (V+); also elsewhere on the board
-15V: C33.1, C34.1, C37.1, C38.1, C41.1, C42.1, U7.4 (V-), U8.4 (V-), U9.4 (V-); also elsewhere on the board
/ControlLogic/ControlLogicMixer/BIAS: U7.3 (+INA); also elsewhere on the board
/ControlLogic/ControlLogicMixer/BIAS_OUT: R14.1, U7.1 (OUTA); also elsewhere on the board
/ControlLogic/ControlLogicMixer/CoarseFineMixer_X/OUT: R15.2, U8.3 (+INA); also elsewhere on the board
/ControlLogic/ControlLogicMixer/CoarseFineMixer_Y/OUT: R17.2, U9.3 (+INA); also elsewhere on the board
/ControlLogic/ControlLogicMixer/TIP: U7.5 (+INB); also elsewhere on the board
/ControlLogic/ControlLogicMixer/TIP_OUT: R13.1, U7.7 (OUTB); also elsewhere on the board
/ControlLogic/OutputBuffer/X1_IN: U8.1 (OUTA), U8.2 (-INA); also elsewhere on the board
/ControlLogic/OutputBuffer/X2_IN: R16.1, U8.7 (OUTB); also elsewhere on the board
/ControlLogic/OutputBuffer/Y1_IN: U9.1 (OUTA), U9.2 (-INA); also elsewhere on the board
/ControlLogic/OutputBuffer/Y2_IN: R18.1, U9.7 (OUTB); also elsewhere on the board
GND: C31.2, C32.2, C33.2, C34.2, C35.2, C36.2, C37.2, C38.2, C39.2, C40.2, C41.2, C42.2, R11.2, R12.2, U8.5 (+INB), U9.5 (+INB); also elsewhere on the board
unnamed: R11.1, R13.2, U7.6 (-INB)
unnamed: R12.1, R14.2, U7.2 (-INA)
unnamed: R15.1, R16.2, U8.6 (-INB)
unnamed: R17.1, R18.2, U9.6 (-INB)

Notes on the sheet:
Sample Voltage Amplifier
Y-Axis Buffer and Inverter
X-Axis Buffer and Inverter

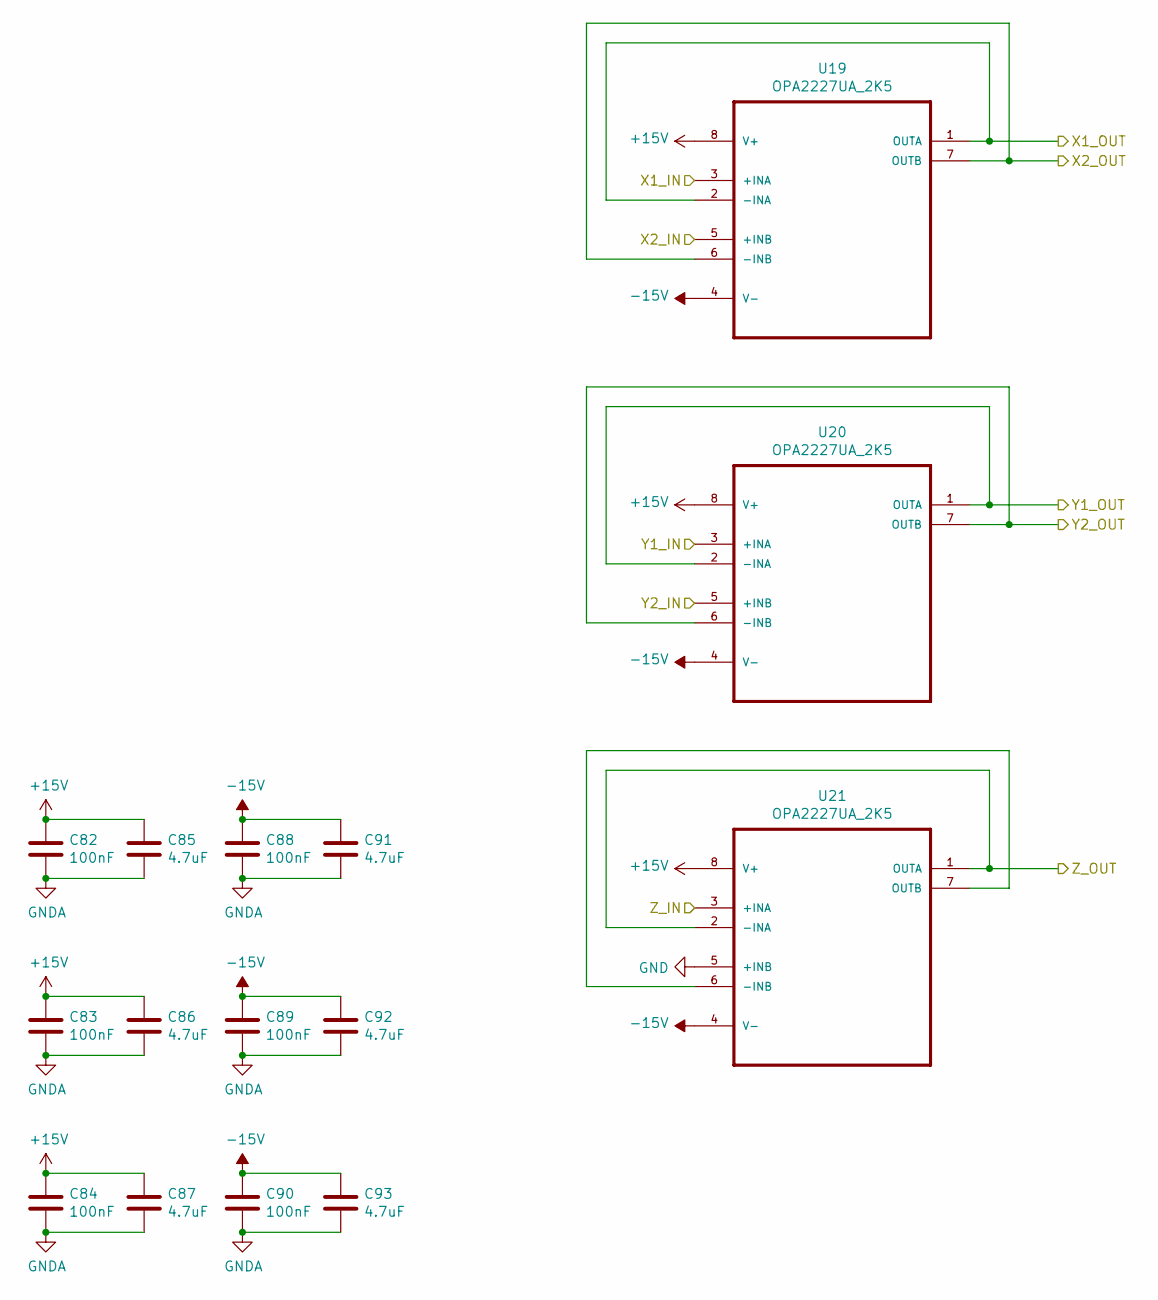
[picture p18: schematic OutputBuffer.sch]

Parts:
C82, C83, C84, C88, C89, C90: 100nF; C_0603_1608Metric_Pad1.05x0.95mm_HandSolder
C85, C86, C87, C91, C92, C93: 4.7uF; C_0805_2012Metric_Pad1.15x1.40mm_HandSolder
U19, U20, U21: OPA2227UA_2K5; SOIC-8-1EP_3.9x4.9mm_P1.27mm_EP2.29x3mm_ThermalVias

Connections:
+15V: C82.1, C83.1, C84.1, C85.1, C86.1, C87.1, U19.8 (V+), U20.8 (V+), U21.8 (V+); also elsewhere on the board
-15V: C88.1, C89.1, C90.1, C91.1, C92.1, C93.1, U19.4 (V-), U20.4 (V-), U21.4 (V-); also elsewhere on the board
/ControlLogic/OutputBuffer/X1_IN: U19.3 (+INA); also elsewhere on the board
/ControlLogic/OutputBuffer/X1_OUT: U19.1 (OUTA), U19.2 (-INA); also elsewhere on the board
/ControlLogic/OutputBuffer/X2_IN: U19.5 (+INB); also elsewhere on the board
/ControlLogic/OutputBuffer/X2_OUT: U19.6 (-INB), U19.7 (OUTB); also elsewhere on the board
/ControlLogic/OutputBuffer/Y1_IN: U20.3 (+INA); also elsewhere on the board
/ControlLogic/OutputBuffer/Y1_OUT: U20.1 (OUTA), U20.2 (-INA); also elsewhere on the board
/ControlLogic/OutputBuffer/Y2_IN: U20.5 (+INB); also elsewhere on the board
/ControlLogic/OutputBuffer/Y2_OUT: U20.6 (-INB), U20.7 (OUTB); also elsewhere on the board
/ControlLogic/OutputBuffer/Z_IN: U21.3 (+INA); also elsewhere on the board
/ControlLogic/OutputBuffer/Z_OUT: U21.1 (OUTA), U21.2 (-INA); also elsewhere on the board
GND: C82.2, C83.2, C84.2, C85.2, C86.2, C87.2, C88.2, C89.2, C90.2, C91.2, C92.2, C93.2, U21.5 (+INB); also elsewhere on the board
unnamed: U21.6 (-INB), U21.7 (OUTB)

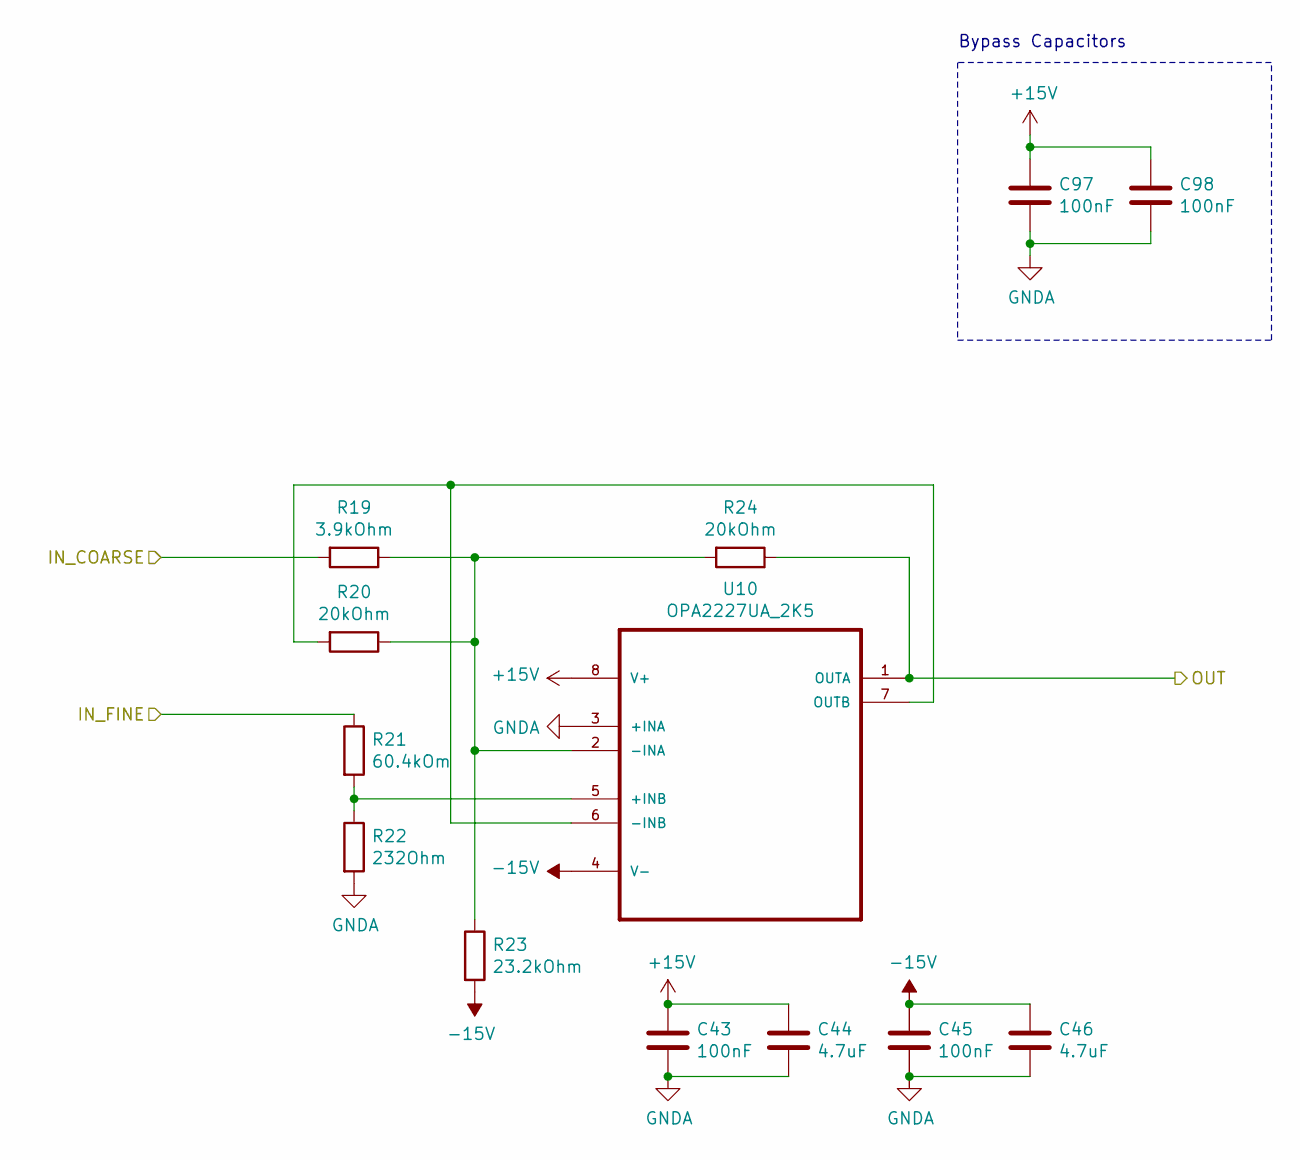
[picture p19: schematic CoarseFineMixer.sch]

Parts:
C51, C53, C97, C98: 100nF; C_0603_1608Metric_Pad1.05x0.95mm_HandSolder
C52, C54: 4.7uF; C_0805_2012Metric_Pad1.15x1.40mm_HandSolder
R31: 3.9kOhm; R_0603_1608Metric_Pad1.05x0.95mm_HandSolder
R32, R36: 20kOhm; R_0603_1608Metric_Pad1.05x0.95mm_HandSolder
R33: 60.4kOm; R_0603_1608Metric_Pad1.05x0.95mm_HandSolder
R34: 232Ohm; R_0603_1608Metric_Pad1.05x0.95mm_HandSolder
R35: 23.2kOhm; R_0603_1608Metric_Pad1.05x0.95mm_HandSolder
U12: OPA2227UA_2K5; SOIC-8-1EP_3.9x4.9mm_P1.27mm_EP2.29x3mm_ThermalVias

Connections:
+15V: C51.1, C52.1, C97.1, C98.1, U12.8 (V+); also elsewhere on the board
-15V: C53.1, C54.1, R35.2, U12.4 (V-); also elsewhere on the board
/ControlLogic/ControlLogicMixer/CoarseFineMixer_X/OUT: R36.1, U12.1 (OUTA); also elsewhere on the board
/ControlLogic/ControlLogicMixer/X1: R31.2; also elsewhere on the board
/ControlLogic/ControlLogicMixer/X2: R33.1; also elsewhere on the board
GND: C51.2, C52.2, C53.2, C54.2, C97.2, C98.2, R34.2, U12.3 (+INA); also elsewhere on the board
unnamed: R31.1, R32.1, R35.1, R36.2, U12.2 (-INA)
unnamed: R32.2, U12.6 (-INB), U12.7 (OUTB)
unnamed: R33.2, R34.1, U12.5 (+INB)

Parts of its further copies:
C43, C45, C47, C49, C99, C100, C101, C102: 100nF; C_0603_1608Metric_Pad1.05x0.95mm_HandSolder
C44, C46, C48, C50: 4.7uF; C_0805_2012Metric_Pad1.15x1.40mm_HandSolder
R19, R25: 3.9kOhm; R_0603_1608Metric_Pad1.05x0.95mm_HandSolder
R20, R24, R26, R30: 20kOhm; R_0603_1608Metric_Pad1.05x0.95mm_HandSolder
R21, R27: 60.4kOm; R_0603_1608Metric_Pad1.05x0.95mm_HandSolder
R22, R28: 232Ohm; R_0603_1608Metric_Pad1.05x0.95mm_HandSolder
R23, R29: 23.2kOhm; R_0603_1608Metric_Pad1.05x0.95mm_HandSolder
U10, U11: OPA2227UA_2K5; SOIC-8-1EP_3.9x4.9mm_P1.27mm_EP2.29x3mm_ThermalVias

Connections of its further copies:
+15V: C43.1, C44.1, C47.1, C48.1, C99.1, C100.1, C101.1, C102.1, U10.8 (V+), U11.8 (V+); also elsewhere on the board
-15V: C45.1, C46.1, C49.1, C50.1, R23.2, R29.2, U10.4 (V-), U11.4 (V-); also elsewhere on the board
/ControlLogic/ControlLogicMixer/CoarseFineMixer_Y/OUT: R30.1, U11.1 (OUTA); also elsewhere on the board
/ControlLogic/ControlLogicMixer/Y1: R25.2; also elsewhere on the board
/ControlLogic/ControlLogicMixer/Y2: R27.1; also elsewhere on the board
/ControlLogic/ControlLogicMixer/Z1: R19.2; also elsewhere on the board
/ControlLogic/ControlLogicMixer/Z2: R21.1; also elsewhere on the board
/ControlLogic/OutputBuffer/Z_IN: R24.1, U10.1 (OUTA); also elsewhere on the board
GND: C43.2, C44.2, C45.2, C46.2, C47.2, C48.2, C49.2, C50.2, C99.2, C100.2, C101.2, C102.2, R22.2, R28.2, U10.3 (+INA), U11.3 (+INA); also elsewhere on the board
unnamed: R19.1, R20.1, R23.1, R24.2, U10.2 (-INA)
unnamed: R20.2, U10.6 (-INB), U10.7 (OUTB)
unnamed: R21.2, R22.1, U10.5 (+INB)
unnamed: R25.1, R26.1, R29.1, R30.2, U11.2 (-INA)
unnamed: R26.2, U11.6 (-INB), U11.7 (OUTB)
unnamed: R27.2, R28.1, U11.5 (+INB)

Notes on the sheet:
Bypass Capacitors

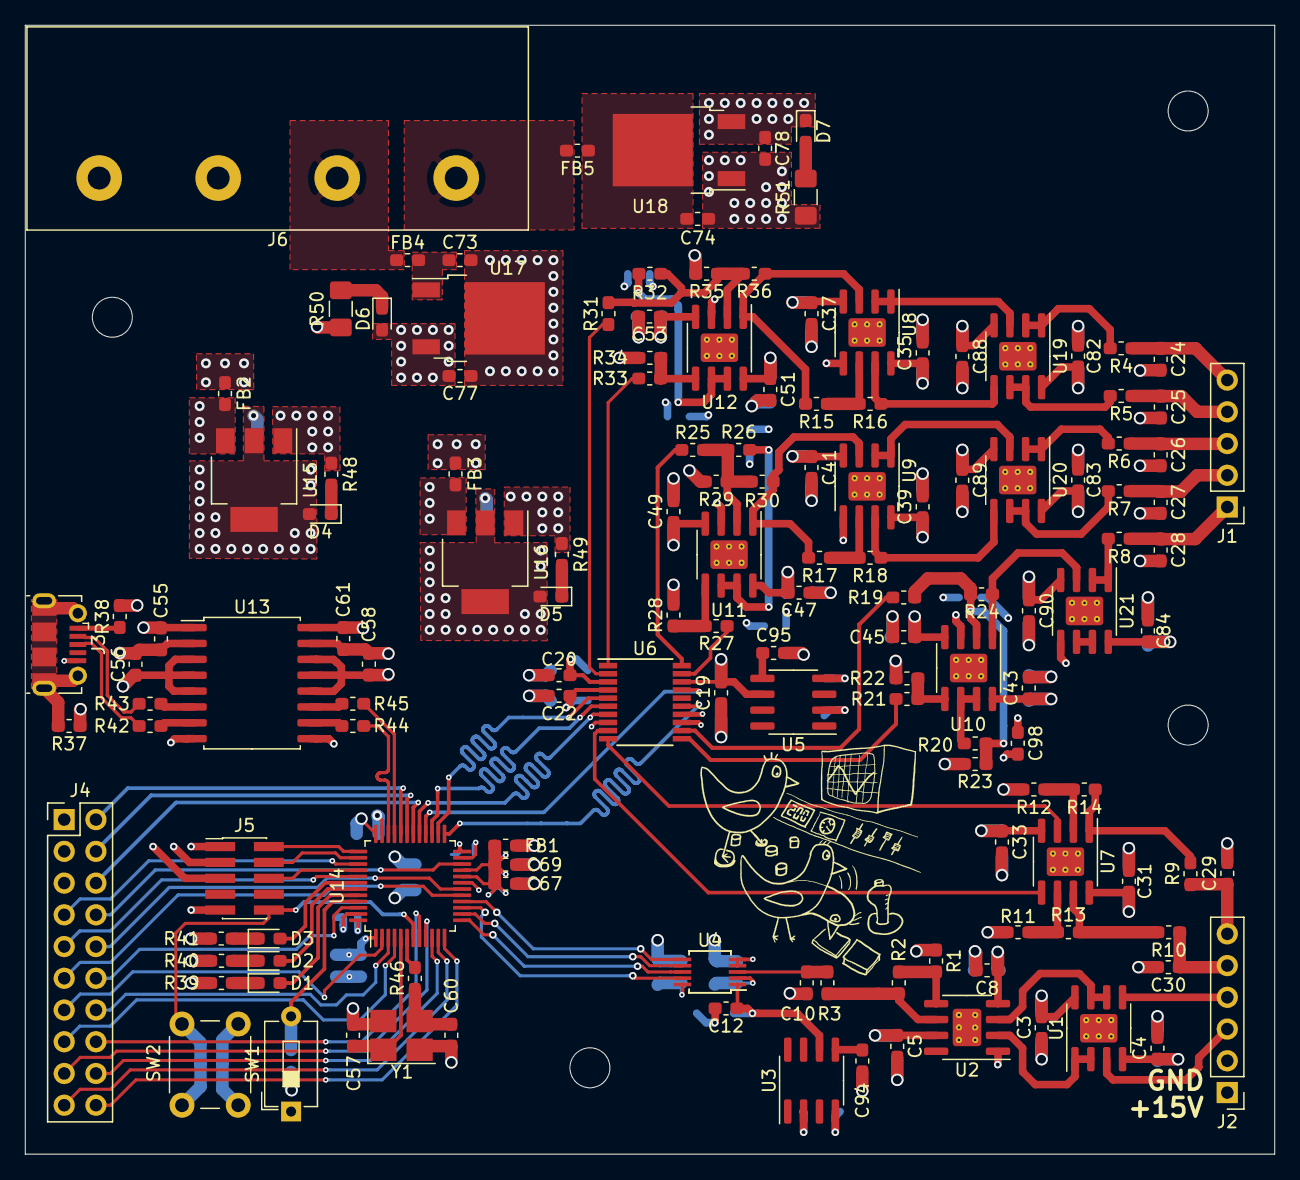
[picture p20: board ControlBoard.kicad_pcb from above]

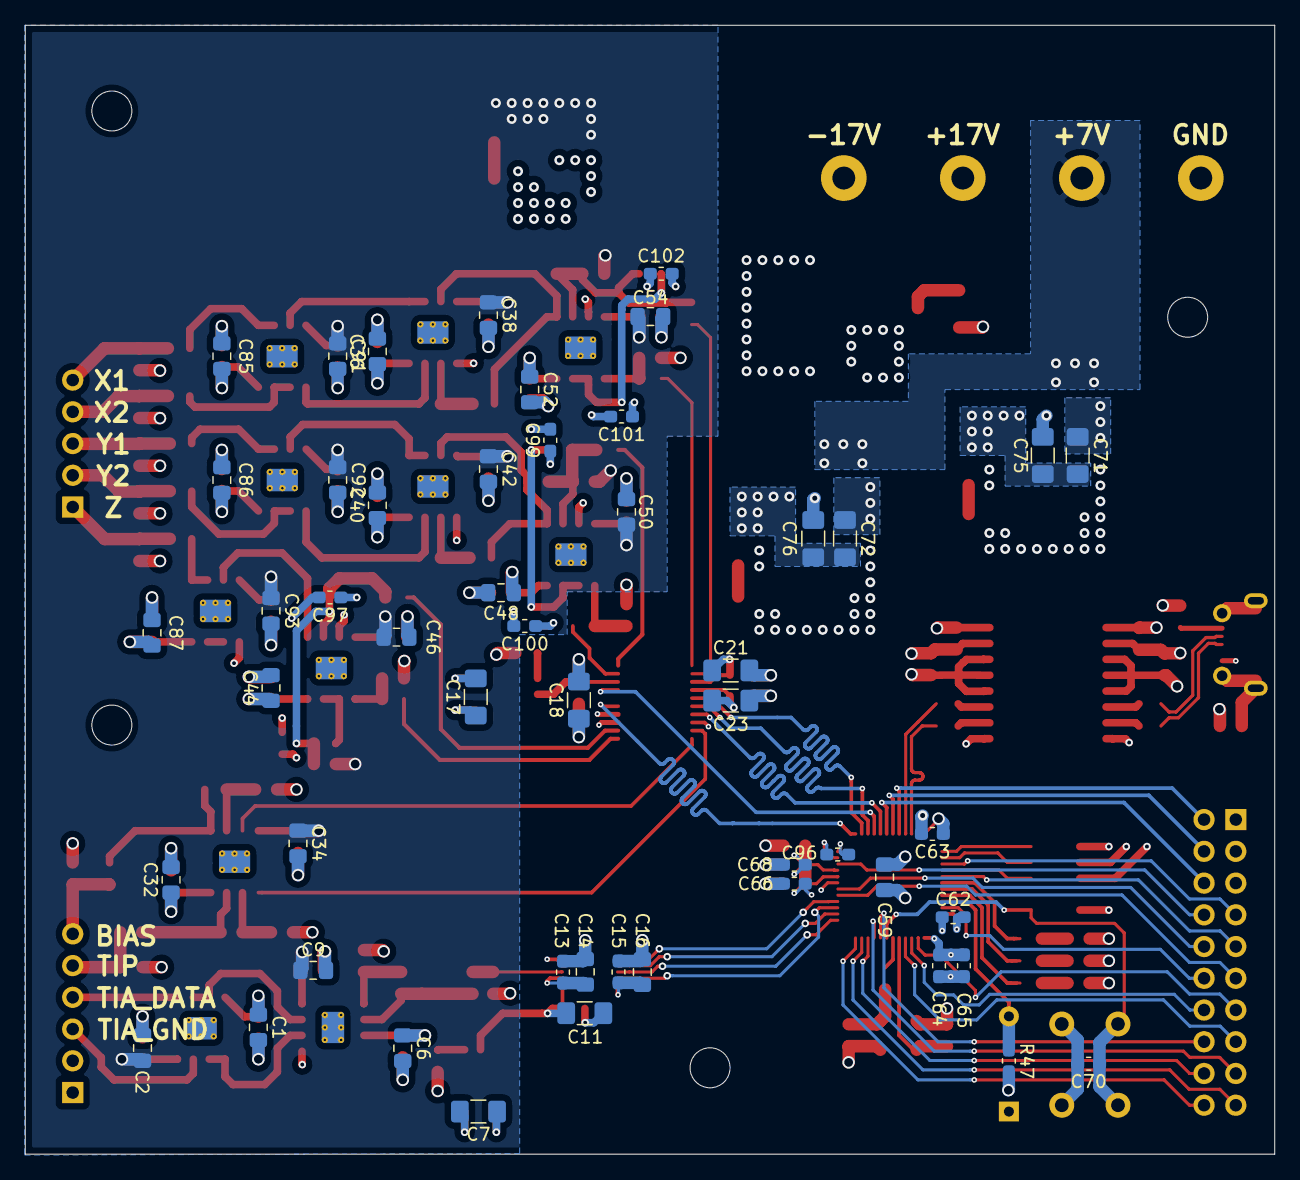
[picture p21: board ControlBoard.kicad_pcb from below]

Board: 4 copper layers, 100.0 x 90.4 mm, 192 parts (51 on the bottom side), 123 nets.
