TobiasRohner/STM/Software/STM/Core/Src/main.c

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
/* Includes ------------------------------------------------------------------*/
#include "main.h"
#include "usb_device.h"

/* USER CODE BEGIN Includes */
#include "usbd_cdc_if.h"
#include <control_logic.h>
#include <data_acquisition.h>
/* USER CODE END Includes */


void SystemClock_Config(void);
static void MX_GPIO_Init(void);
static void MX_CORDIC_Init(void);
static void MX_SPI1_Init(void);
static void MX_SPI2_Init(void);
static void MX_USART1_UART_Init(void);
/* USER CODE BEGIN 0 */

char msg[256];

/* USER CODE END 0 */

/**
  * @brief  The application entry point.
  * @retval int
  */
int main(void)
{
  /* MCU Configuration--------------------------------------------------------*/

  /* Reset of all peripherals, Initializes the Flash interface and the Systick. */
  HAL_Init();

  /* Configure the system clock */
  SystemClock_Config();

  /* Initialize all configured peripherals */
  MX_GPIO_Init();
  MX_CORDIC_Init();
  MX_SPI1_Init();
  MX_SPI2_Init();
  MX_USART1_UART_Init();
  MX_USB_Device_Init();
  /* USER CODE BEGIN 2 */
  DAC_Init();
  ADC_Init();
  /* USER CODE END 2 */

  /* Infinite loop */
  /* USER CODE BEGIN WHILE */
  //uint16_t lvl = 0;
  uint16_t high = 0;
  uint16_t low = 0;
  uint16_t calibration = 0x12FF;
  CDC_ReceivedCommand[0] = '\0';
  CDC_ReceiveCommandSize = 0;
  while (1)
  {
	  // Change the calibration parameter over USB
	  if (CDC_ReceiveCommandSize != 0 && CDC_ReceivedCommand[CDC_ReceiveCommandSize-1] == '\r') {
		  CDC_Transmit_FS(CDC_ReceivedCommand, CDC_ReceiveCommandSize);
		  int delta;
		  scanf("%i", &delta);
		  calibration += delta;
		  sprintf(msg, "Changed calibration by %d. New calibration is %x.\n\r", delta, calibration);
		  CDC_Transmit_FS((uint8_t*)msg, strlen(msg));
		  CDC_ReceivedCommand[0] = '\0';
		  CDC_ReceiveCommandSize = 0;
	  }
	  // Set the DAC output to mid range (Final output approx. 0V)
	  high = 0x8178;
	  low = 0x0000;
	  // Increase output for 2 carrys to high
	  int n_carrys = 0;
	  while (n_carrys < 16) {
		  DAC_WriteCmd(DAC_CMD_WRITE_INPUT_REG, DAC_ADDR_X_COARSE, high);
		  DAC_WriteCmd(DAC_CMD_WRITE_INPUT_REG, DAC_ADDR_X_FINE, low);
		  DAC_WriteCmd(DAC_CMD_UPDATE_REG, 0, (1<<DAC_ADDR_X_COARSE)|(1<<DAC_ADDR_X_FINE));
		  n_carrys += ControlLogic_IncrementCompoundDAC(calibration, &high, &low, 1);
	  }
	  /*
	  DAC_WriteCmd(DAC_CMD_UPDATE_CHANNEL, DAC_ADDR_X_COARSE, lvl);
	  volatile uint16_t U_real = lvl;
	  ADC_StartConversion();
	  volatile uint16_t U_measured = ADC_Readout();
	  ++lvl;
	  sprintf(msg, "\rU_real = %d,\tU_measured = %d,\tU_diff = %d\t", U_real, U_measured, U_measured-U_real);
	  CDC_Transmit_FS((uint8_t*)msg, strlen(msg));
	  */
    /* USER CODE END WHILE */

    /* USER CODE BEGIN 3 */
  }
  /* USER CODE END 3 */
}

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
