TobiasRohner/STM/Software/STM/Core/Inc/main.h

#define NRST_Pin LL_GPIO_PIN_10
#define NRST_GPIO_Port GPIOG
#define SPI1_MOSI_Pin LL_GPIO_PIN_7
#define SPI1_MOSI_GPIO_Port GPIOA
#define DA_CNV_Pin LL_GPIO_PIN_0
#define DA_CNV_GPIO_Port GPIOB
#define CTRL_LDAC_INV_Pin LL_GPIO_PIN_11
#define CTRL_LDAC_INV_GPIO_Port GPIOB
#define CTRL_SYNC_INV_Pin LL_GPIO_PIN_12
#define CTRL_SYNC_INV_GPIO_Port GPIOB
#define CTRL_RESET_INV_Pin LL_GPIO_PIN_14
#define CTRL_RESET_INV_GPIO_Port GPIOB
#define LED_G_Pin LL_GPIO_PIN_5
#define LED_G_GPIO_Port GPIOB
#define LED_Y_Pin LL_GPIO_PIN_6
#define LED_Y_GPIO_Port GPIOB
#define LED_R_Pin LL_GPIO_PIN_7
#define LED_R_GPIO_Port GPIOB
#define BOOT0_Pin LL_GPIO_PIN_8
#define BOOT0_GPIO_Port GPIOB
#define MCU_FREQ 96000000
